cosidelu/vision-guided-helmet-inspection/documents/Presentazione_INNOVATIVE_APPLICATIONS_OF_INDUSTRIAL_ROBOTICS.pdf

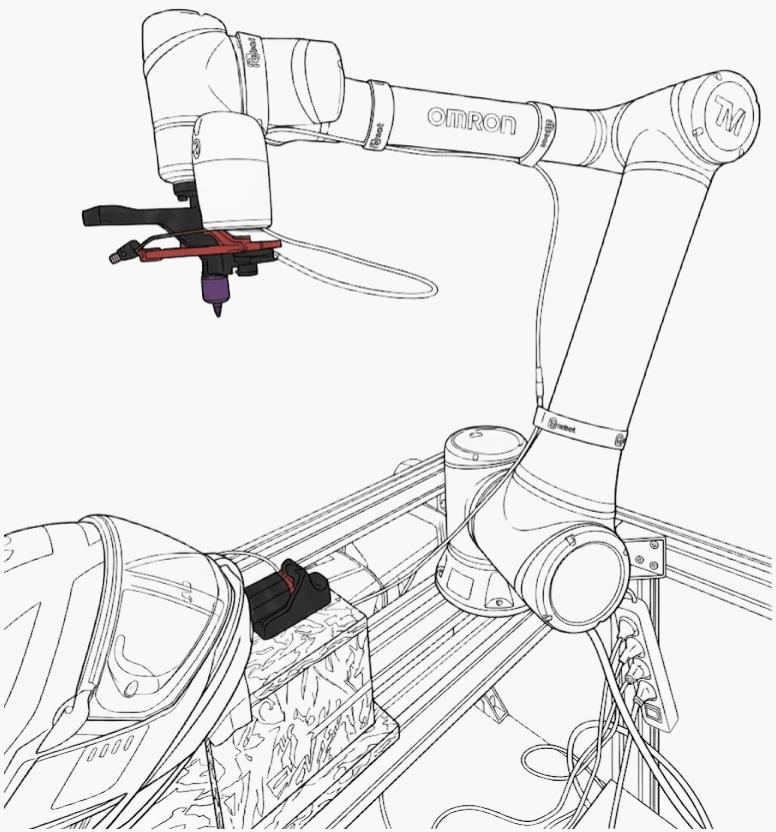
[picture p17: figure]

I NNO V AT I V E AP P L I C AT I O NS O F I NDUS T RI AL RO BO T I CS

# Robotic Cell for Automated Helmet Visor Testing and Visual Inspection

Authors

Cosimo De Luca · Matteo Casazza · Francesco Giglio · Marco Giavazzi

Alberto Feltrin · Donato Miraglia
Supervisor

Giovanni Bianchi

Academic Year

2025 / 2026

T HE G O AL

# PROJECT OBJECTIVES

Six pillars — each one anchors a section of this deck

CONSTRAINING

Constrain the helmet

rigidly & repeatably

END EFFECTOR

Integrated tool:

handling, vision &

marking

HANDLING

Robot control & Visor

tasks

ACQUISITION

Capture the surface

with the stereo-camera

DETECTION

Locate surface

defects automatically

INSPECTION
& MARKING
Identify, refine and mark

each detected defect

S E C T I O N 0 1 / 0 6

# Constraining

## Constrain the helmet rigidly and repeatably

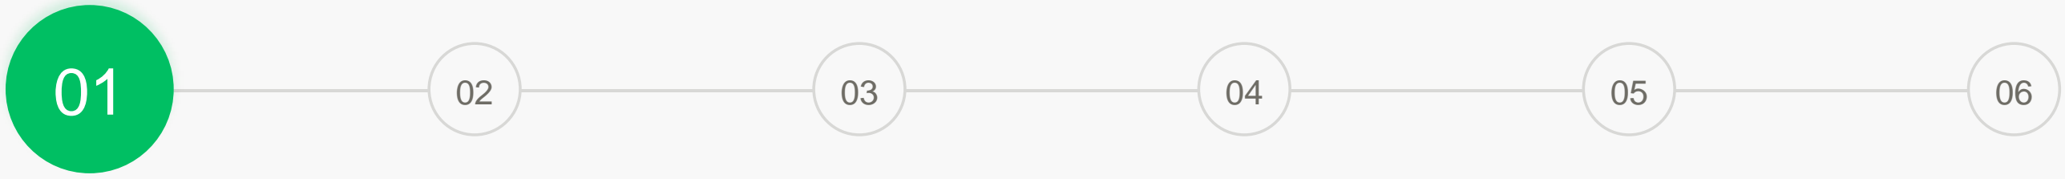
[picture p18: figure]

CONSTRAINING | END EFFECTOR | HANDLING | ACQUISITION | DETECTION | INSPECTION & MARKING

T HE O BJE CT

# ANATOMY OF THE HELMET

Key features the cell must handle

Constraining · Stage 1 / 6

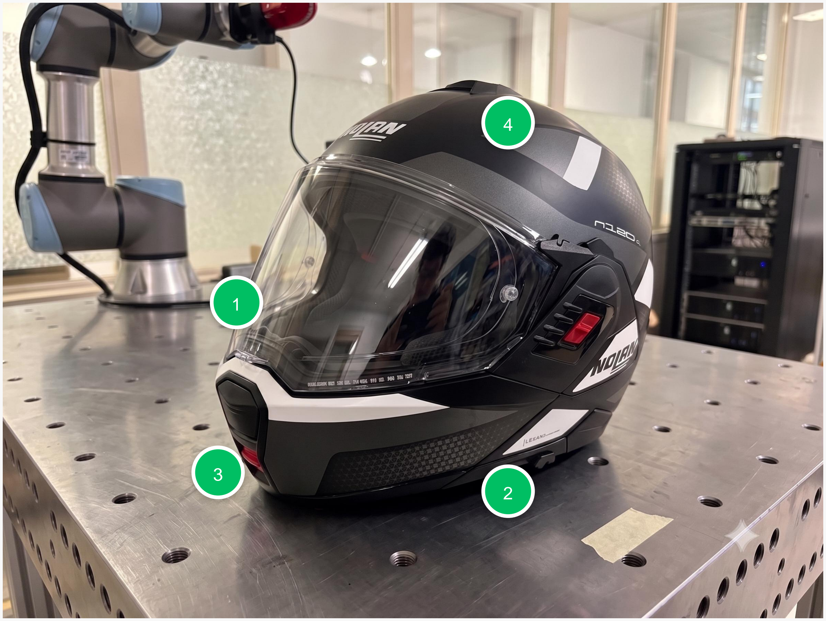
[picture p19: figure]

01 | Visor tab
| Tab that help for the opening of the visor
03 | Chin bar release button
| A mechanism to release the lower part of the
| helmet
02 | Sun-visor levers
| Slider that opens the inner sun visor and button
| to close it
04 | Inspection zone
| Zone of the helmet we have to inspect to find
| eventual damage

# DESIGNING THE FIXTURE

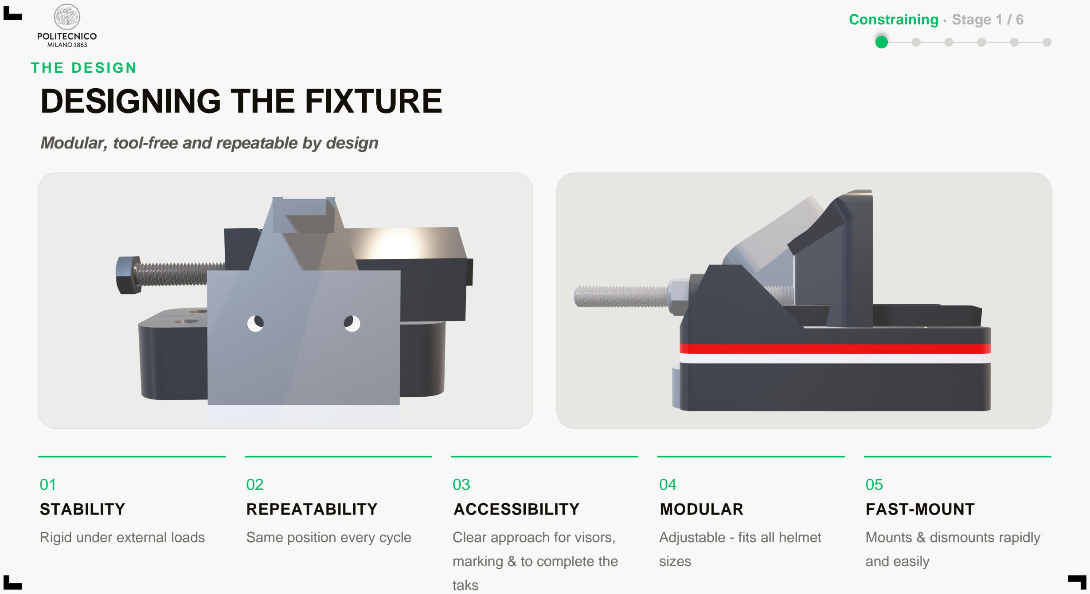
[picture p20: page 5]

T HE DE S I G N

Modular, tool-free and repeatable by design

Constraining · Stage 1 / 6

C

01
STABILITY

Rigid under external loads

02
REPEATABILITY

Same position every cycle

03
ACCESSIBILITY

Clear approach for visors,

marking & to complete the

taks

04
MODULAR

Adjustable - fits all helmet

sizes

05
FAST-MOUNT

Mounts & dismounts rapidly

and easily

# THE CLAMPING SYSTEM

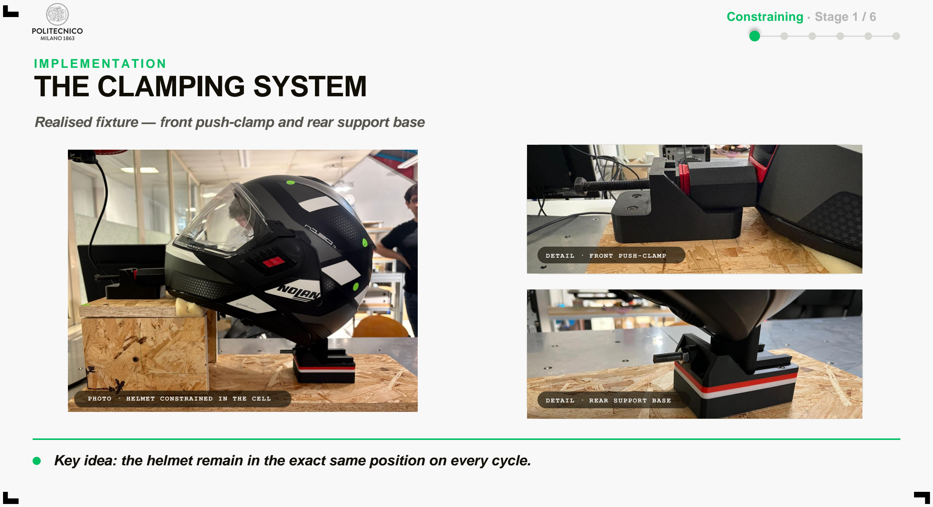
[picture p21: page 6]

I M P L E M E NT AT I O N

Realised fixture — front push-clamp and rear support base

Constraining · Stage 1 / 6

DET AIL · F RON T PU SH-CLA MP

DET AIL · R EAR S UP POR T B AS E

Key idea: the helmet remain in the exact same position on every cycle.

PHO TO · HE LME T CO NST RAI NE D IN TH E CEL L

# FORCES

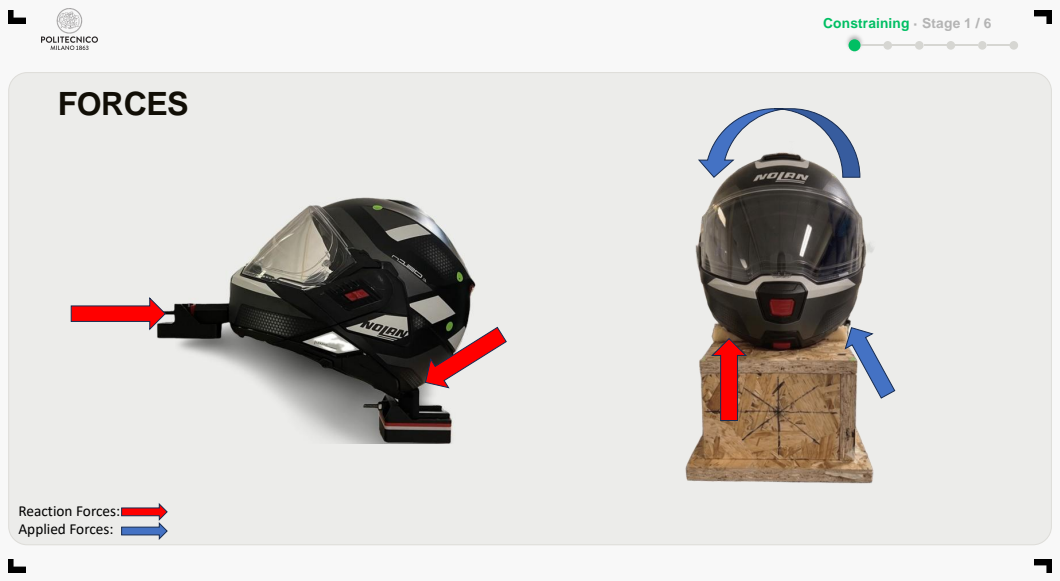
[picture p22: page 7]
Constraining · Stage 1 / 6; Reaction Forces: Applied Forces:

S E C T I O N 0 2 / 0 6

# End Effector

## One integrated tool for handling, vision and marking

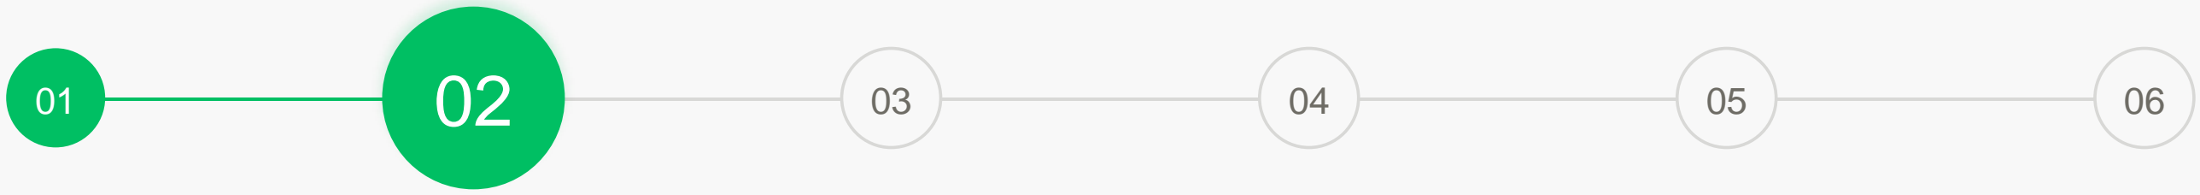
[picture p23: figure]

CONSTRAINING | END EFFECTOR | HANDLING | ACQUISITION | DETECTION | INSPECTION & MARKING

T HE DE S I G N

# END-EFFECTOR DESIGN

CAD model and bill of materials

End Effector · Stage 2 / 6

BILL OF MATERIALS

# | COMPONENT | QTY

01 | Base + Integrated Finger Rigid frame, robot mount & finger — One printed piece | 1
02 | Stereo-camera support
| Holds the ZED mini

1

03 | ZED mini stereo-camera
| 3D surface acquisition

1

04 | LED ring + support
| Illumination system

1

05 | Marker system
| Cap, Marker, Spring – Marking defects

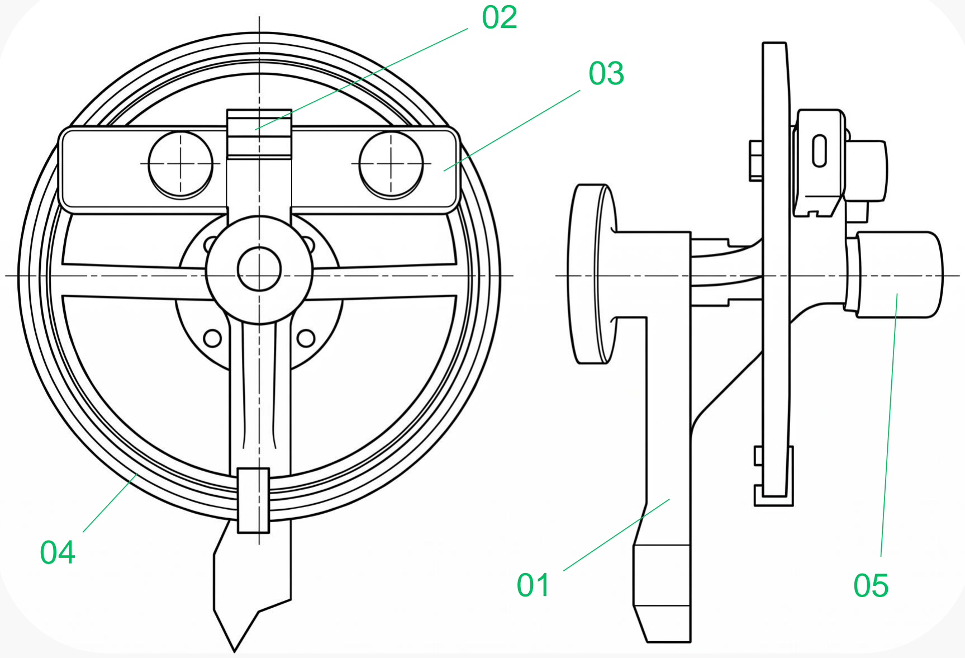
[picture p24: figure]

1 01

# ASSEMBLING THE END-EFFECTOR

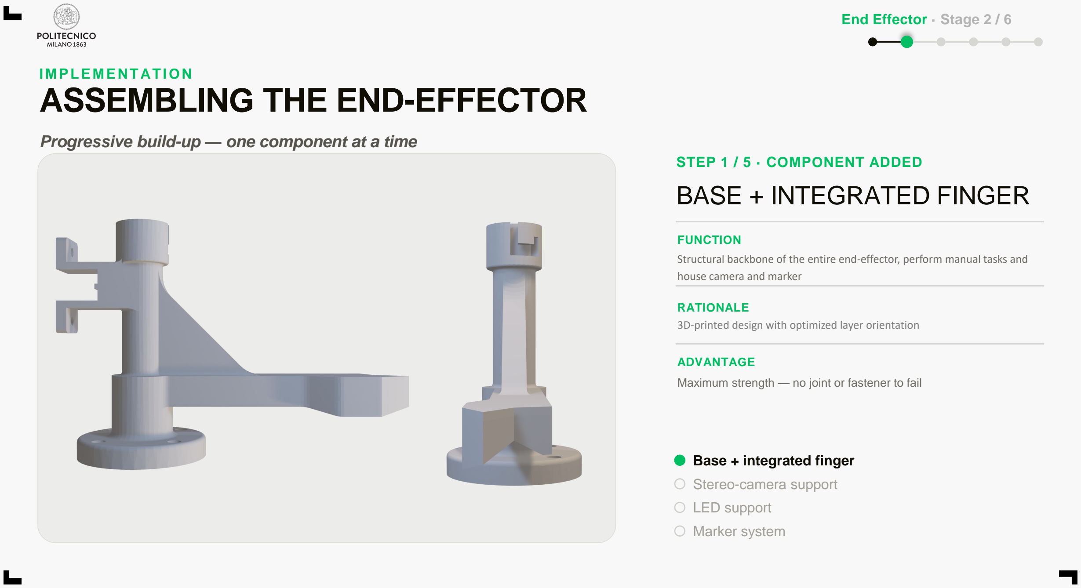
[picture p25: page 10]

I M P L E M E NT AT I O N

Progressive build-up — one component at a time

End Effector · Stage 2 / 6

STEP 1 / 5 · COMPONENT ADDED

# BASE + INTEGRATED FINGER

FUNCTION
Structural backbone of the entire end-effector, perform manual tasks and house camera and marker

RATIONALE
3D-printed design with optimized layer orientation

ADVANTAGE

Maximum strength — no joint or fastener to fail

Base + integrated finger

Stereo-camera support

LED support

Marker system

# ASSEMBLING THE END-EFFECTOR

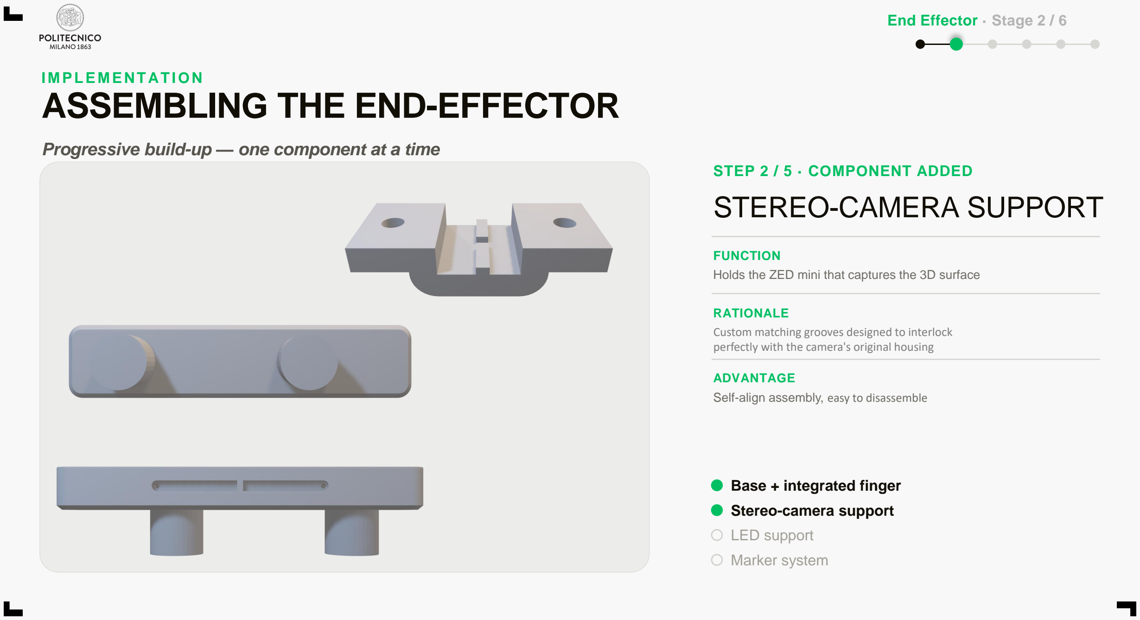
[picture p26: page 11]

I M P L E M E NT AT I O N

Progressive build-up — one component at a time

End Effector · Stage 2 / 6

STEP 2 / 5 · COMPONENT ADDED

# STEREO-CAMERA SUPPORT

FUNCTION
Holds the ZED mini that captures the 3D surface

RATIONALE
Custom matching grooves designed to interlock perfectly with the camera's original housing

ADVANTAGE
Self-align assembly, easy to disassemble

Base + integrated finger

Stereo-camera support

LED support

Marker system

# ASSEMBLING THE END-EFFECTOR

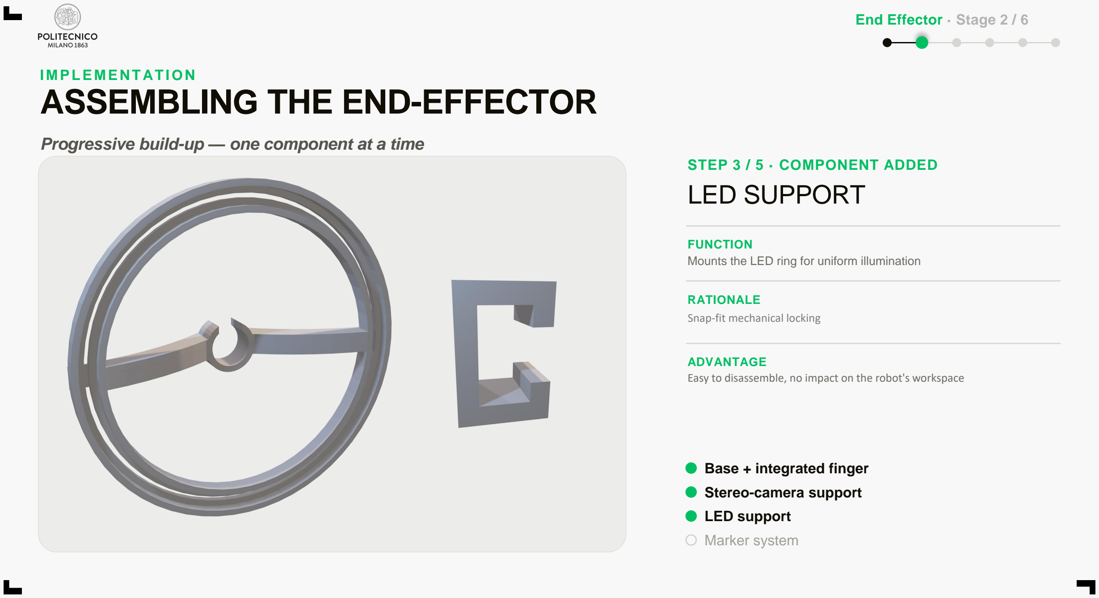
[picture p27: page 12]

I M P L E M E NT AT I O N

Progressive build-up — one component at a time

End Effector · Stage 2 / 6

STEP 3 / 5 · COMPONENT ADDED

# LED SUPPORT

FUNCTION
Mounts the LED ring for uniform illumination

RATIONALE
Snap-fit mechanical locking

ADVANTAGE
Easy to disassemble, no impact on the robot's workspace

Base + integrated finger

Stereo-camera support

LED support

Marker system

# ASSEMBLING THE END-EFFECTOR

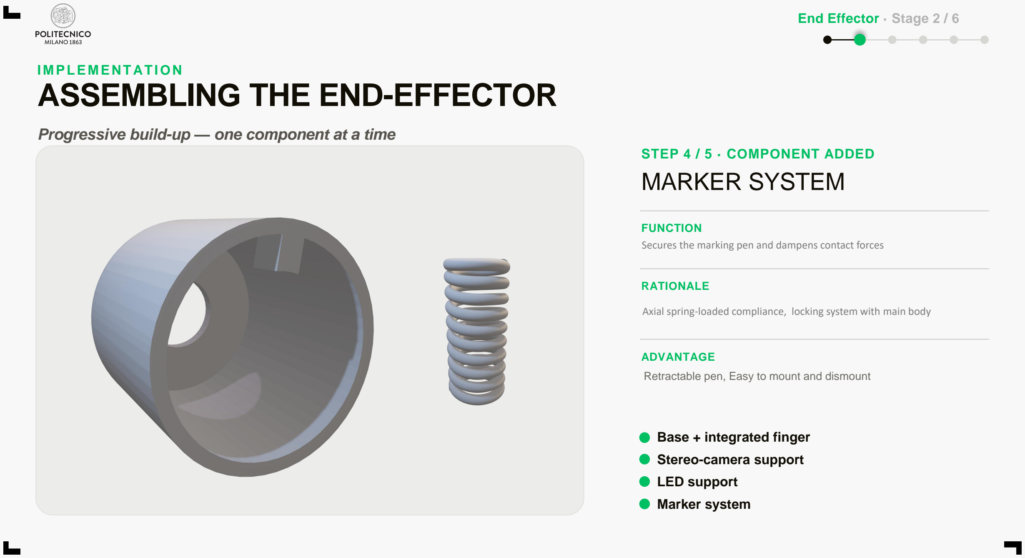
[picture p28: page 13]

I M P L E M E NT AT I O N

Progressive build-up — one component at a time

End Effector · Stage 2 / 6

STEP 4 / 5 · COMPONENT ADDED

# MARKER SYSTEM

FUNCTION
Secures the marking pen and dampens contact forces

RATIONALE

Axial spring-loaded compliance, locking system with main body

ADVANTAGE

Retractable pen, Easy to mount and dismount

Base + integrated finger

Stereo-camera support

LED support

Marker system

# ASSEMBLING THE END-EFFECTOR

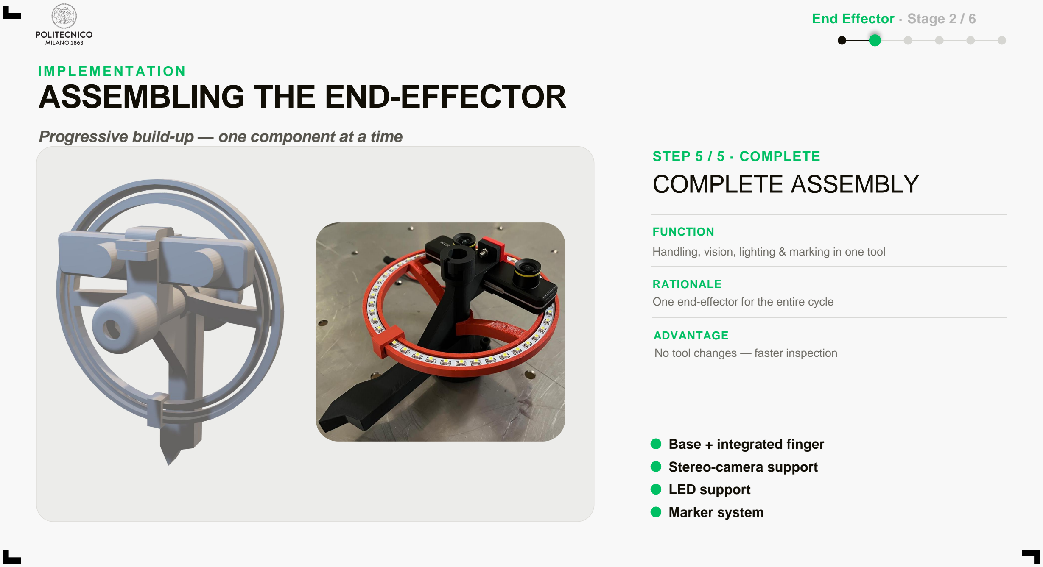
[picture p29: page 14]

I M P L E M E NT AT I O N

Progressive build-up — one component at a time

End Effector · Stage 2 / 6

STEP 5 / 5 · COMPLETE

# COMPLETE ASSEMBLY

FUNCTION

Handling, vision, lighting & marking in one tool

RATIONALE
One end-effector for the entire cycle

ADVANTAGE
No tool changes — faster inspection

Base + integrated finger

Stereo-camera support

LED support

Marker system

S E C T I O N 0 3 / 0 6

# Handling

## Robot control & Visor tasks

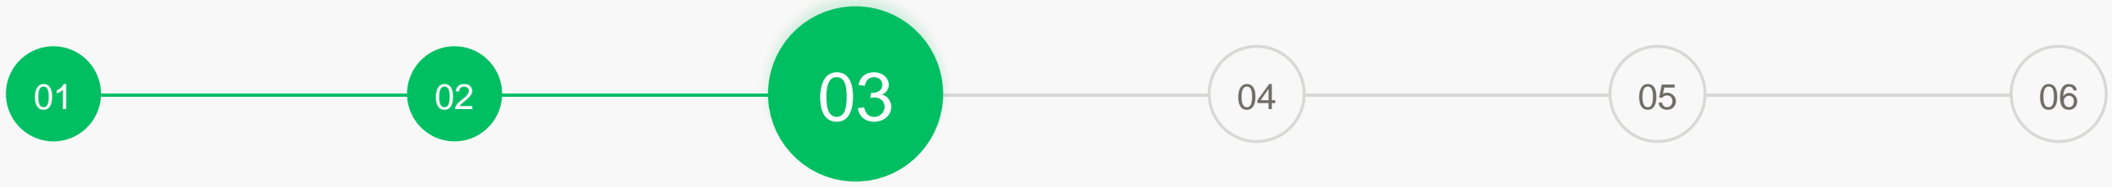
[picture p30: figure]

CONSTRAINING | END EFFECTOR | HANDLING | ACQUISITION | DETECTION | INSPECTION & MARKING

HANDL I NG

# SOFTWARE ARCHITECTURE

Modular architecture, orchestrated by two workflows

Handling · Stage 3 / 6

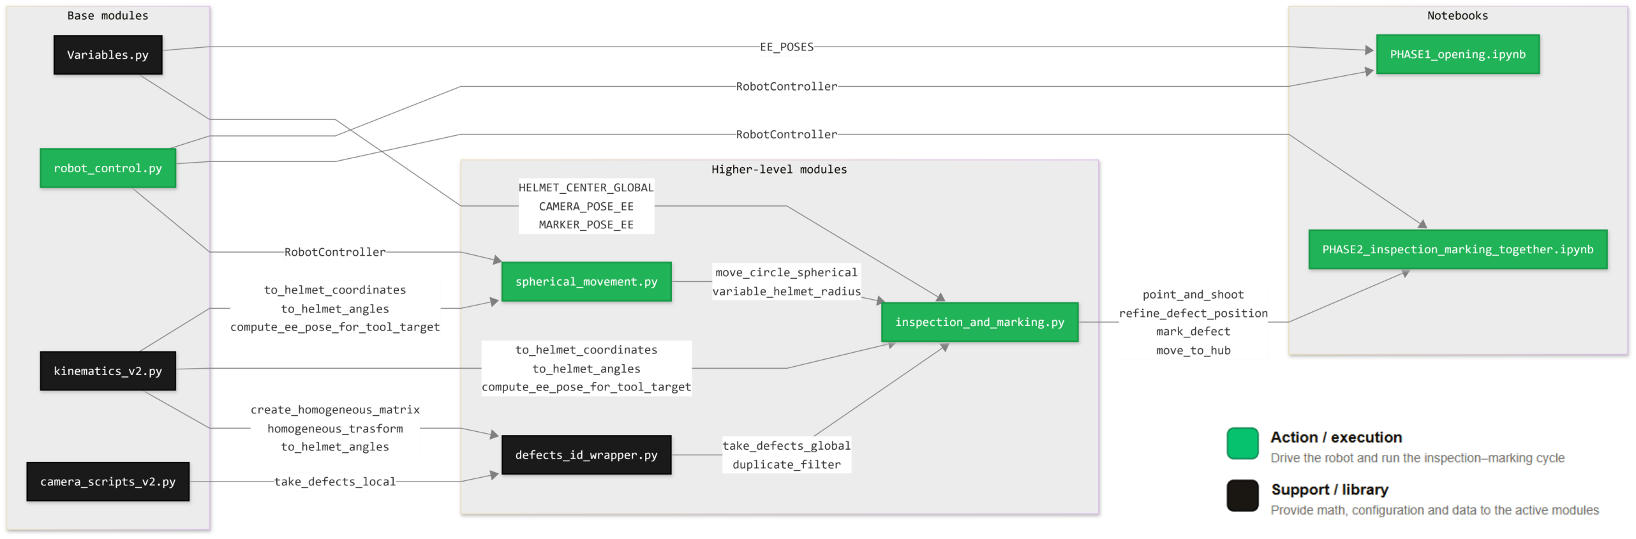
[picture p31: figure]

HANDL I NG

# ROBOT CONTROL

Listen Node commands, Modbus TCP feedback

Handling · Stage 3 / 6

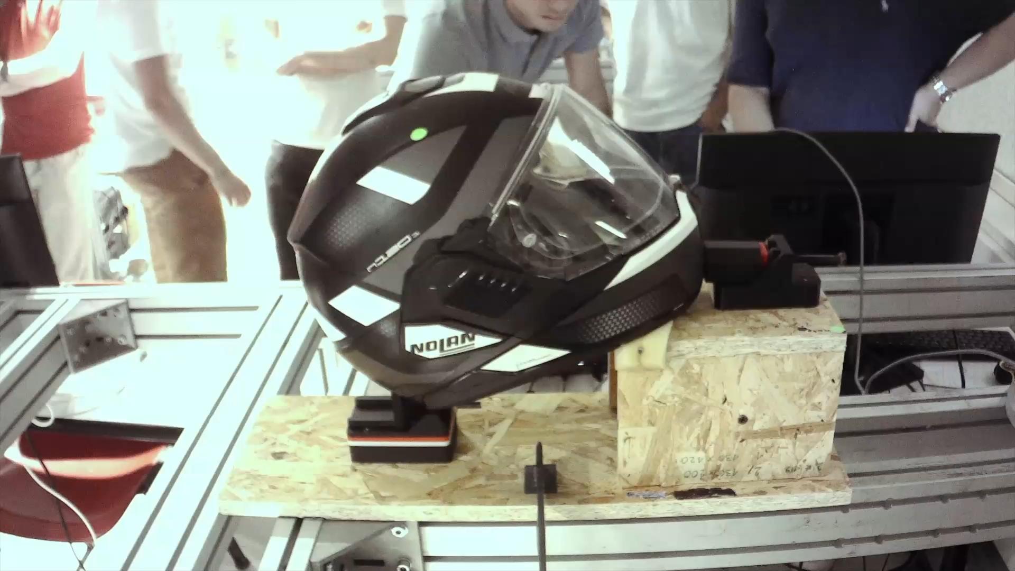
[picture p32: figure]

01 COMMAND INTERFACE
A single class sends motion scripts to the Techman

Listen Node and reads the pose back over Modbus

TCP.

02 SYNCHRONOUS & BLOCKING

The program waits until the robot reaches the target

within a tolerance, by continuously polling the pose

03 MOTION PRIMITIVES
Joint moves, Cartesian point-to-point, linear moves

on the TCP, and 3D arcs
04 SAFETY

Home pose, emergency stop and a movement

timeout

HANDL I NG

# REFERENCE FRAMES & THE MATRIX H

One 4×4 carries rotation and translation

Handling · Stage 3 / 6

01 | FOUR REFERENCE FRAMES Robot base - End-Effector (TCP) - tool (camera and marker, each with its own fixed offset) - helmet
02 | ONE MATRIX H (4×4) Rotation R (3×3) + translation T (3×1) in a single block takes a point

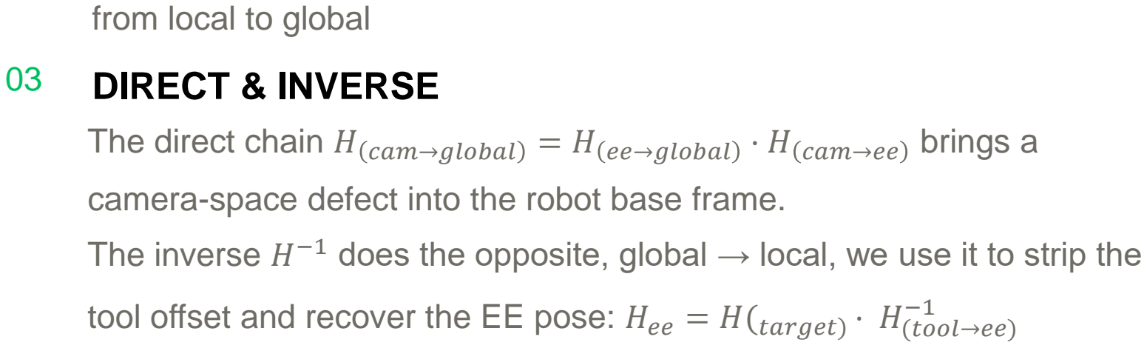
[picture p33: figure]
from local to global; DIRECT & INVERSE; · H cam→ee brings a; The inverse H; · H(tool→ee)

The direct chain H cam→global = H ee→global

camera-space defect into the robot base frame.
−1 does the opposite, global → local, we use it to strip the

tool offset and recover the EE pose: Hee = H(target)

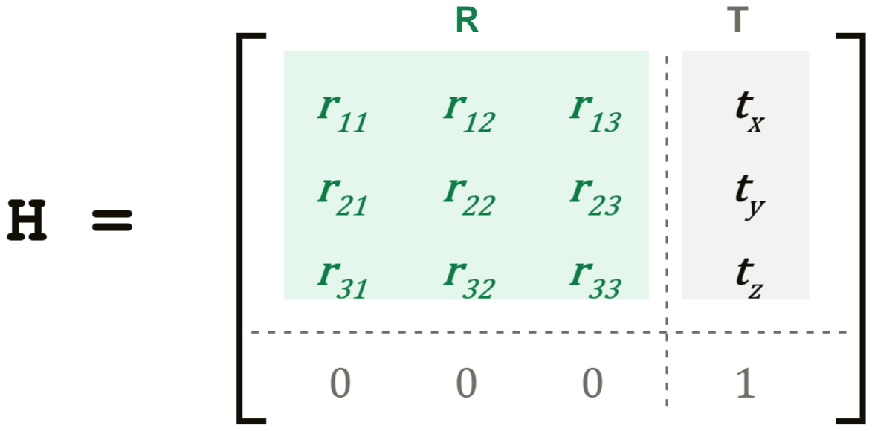
[picture p34: figure]

### P global = H · P local

# ROTATION MATRIX ANGLES

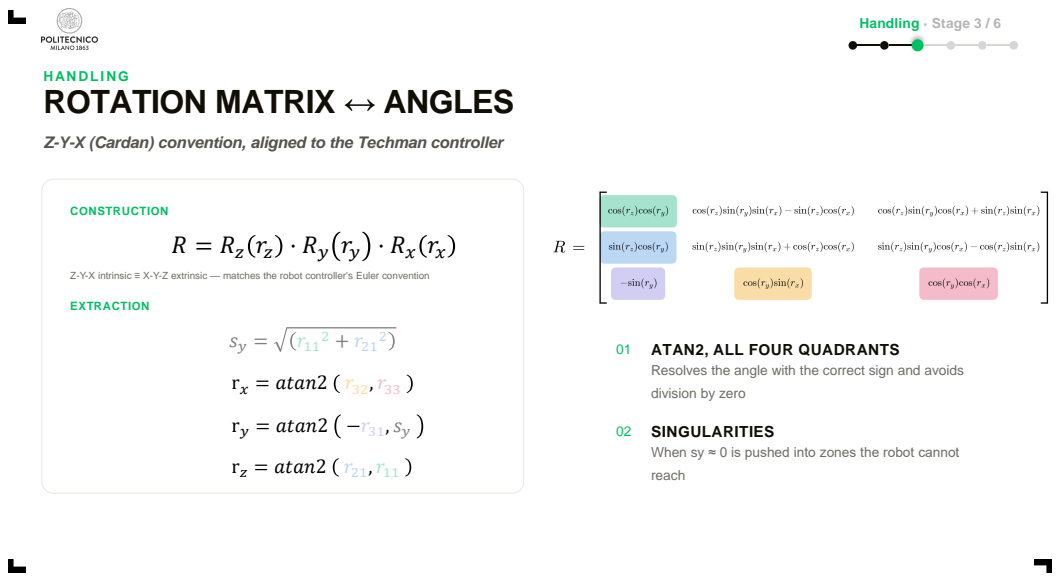
[picture p35: page 19]
HANDL I NG; Handling · Stage 3 / 6; CONSTRUCTION; EXTRACTION; ATAN2, ALL FOUR QUADRANTS; SINGULARITIES; rx = atan2 r32, r33; ry = atan2 −r31, sy; rz = atan2 r21, r11

Z-Y-X (Cardan) convention, aligned to the Techman controller

Z-Y-X intrinsic ≡ X-Y-Z extrinsic — matches the robot controller's Euler convention

Resolves the angle with the correct sign and avoids
division by zero

When sy ≈ 0 is pushed into zones the robot cannot
reach

# FROM OUR ROBOT TO ANY ROBOT

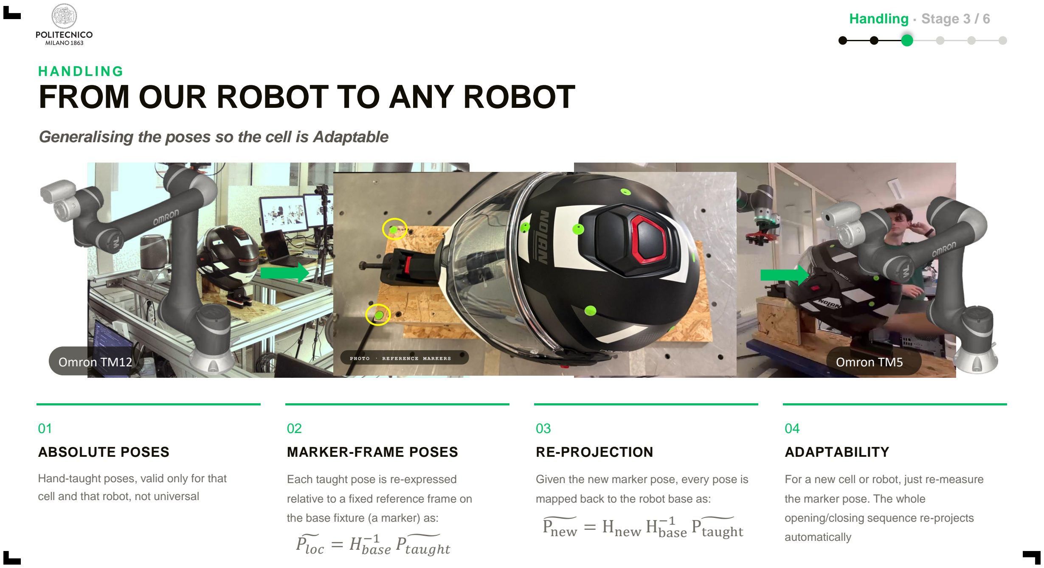
[picture p36: page 20]

HANDL I NG

Generalising the poses so the cell is Adaptable

Handling · Stage 3 / 6

01

ABSOLUTE POSES

Hand-taught poses, valid only for that cell and that robot, not universal

02

MARKER-FRAME POSES

Each taught pose is re-expressed

relative to a fixed reference frame on

the base fixture (a marker) as:

03

RE-PROJECTION

Given the new marker pose, every pose is

mapped back to the robot base as:

04

ADAPTABILITY

For a new cell or robot, just re-measure

the marker pose. The whole

opening/closing sequence re-projects ෫ | automatically
Pnew = Hnew Hbase

−1 P෫taught
P෪loc = Hbase

−1 Ptaugℎt ෫

P H O T O · R E F E R E N C E M A R K E R S Omron TM12 | Omron TM5

S E C T I O N 0 4 / 0 6

# Acquisition

## Capture the surface with the stereo-camera

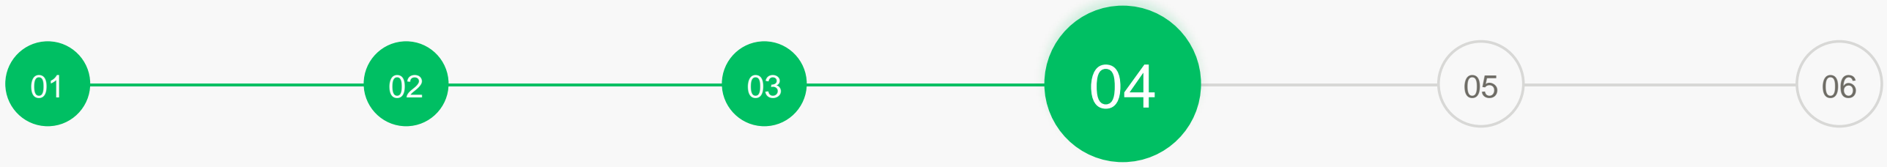
[picture p37: figure]

CONSTRAINING | END EFFECTOR | HANDLING | ACQUISITION | DETECTION | INSPECTION & MARKING

ACQ UI S I T I O N

# AUTOMATED HELMET INSPECTION SYSTEM

3D Computer Vision & Robotic Kinematics for Defect Control

Acquisition · Stage 4 / 6

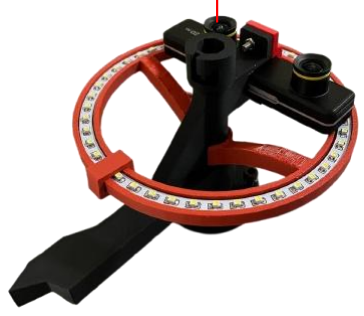
[picture p38: figure]

01 | HELMET CENTER
| The core coordinate
02 | STEREO-CAMERA
| Hardware configuration: Eye-in-Hand-system (camera rigidly attached to the EE)
03 | 3D SURFACE SCANNING
| Continuos, automated 3D surface scanning ensuring perpendicularity

Z෡cam

# ORIENTATION CONSTRAINT: LOCAL Z-AXIS TRACKING

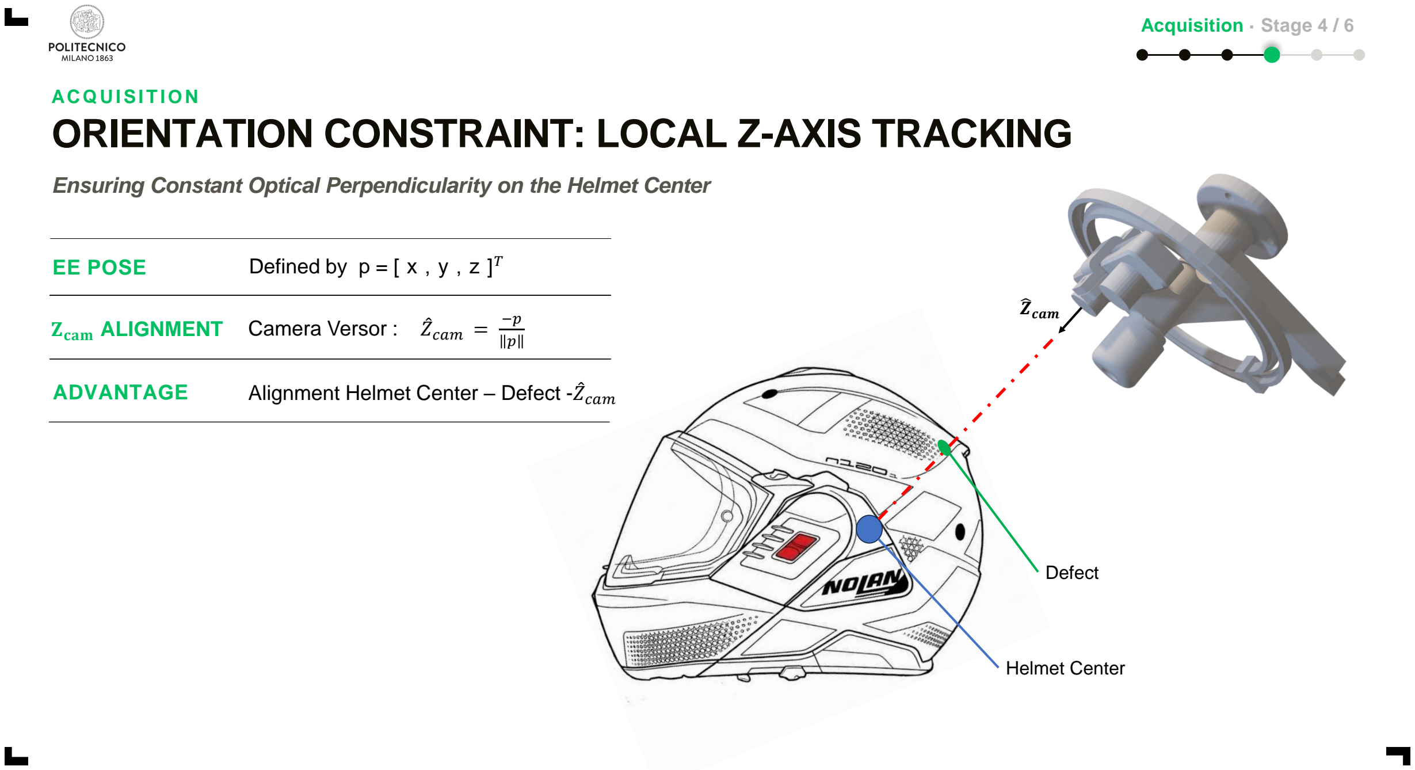
[picture p39: page 23]

ACQ UI S I T I O N

Acquisition · Stage 4 / 6

Ensuring Constant Optical Perpendicularity on the Helmet Center

Helmet Center

Defect

EE POSE | Defined by p = [ x , y , z ] T
Zcam ALIGNMENT | Camera Versor : Zመ cam = −p p
ADVANTAGE | Alignment Helmet Center – Defect -Zመ
cam

Z෡cam

# TRAJECTORY GENERATION: VARIABLE HELMET RADIUS (VHR)

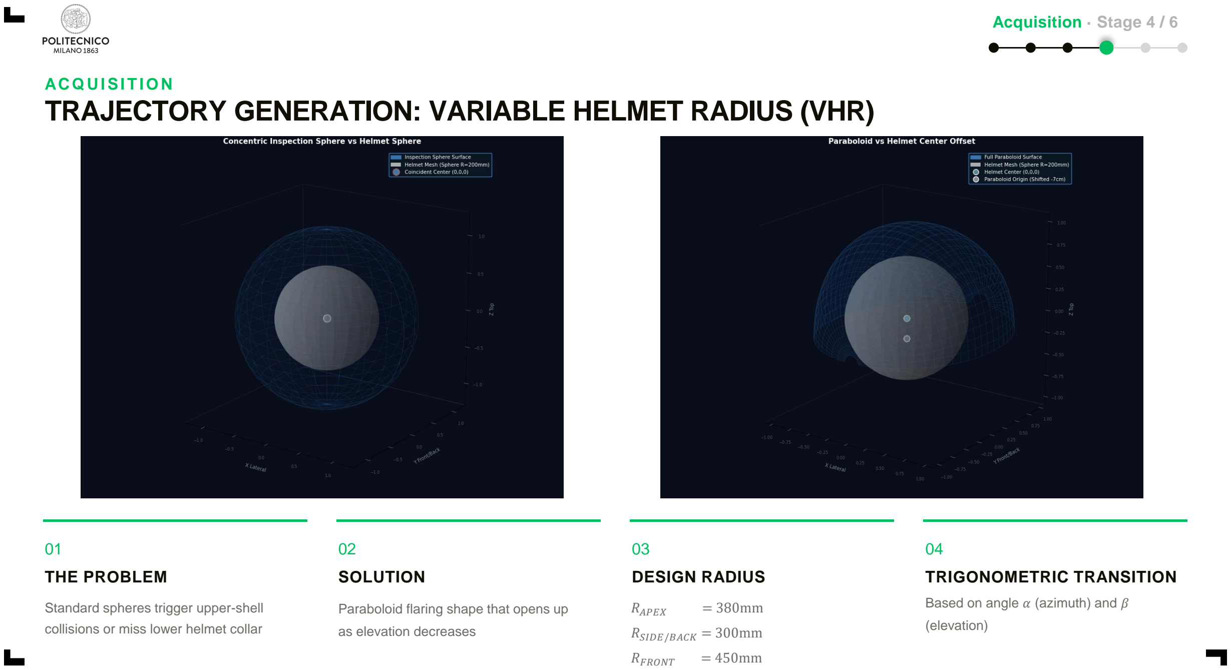
[picture p40: page 24]

ACQ UI S I T I O N

Acquisition · Stage 4 / 6

01

THE PROBLEM

Standard spheres trigger upper-shell collisions or miss lower helmet collar

02

SOLUTION

Paraboloid flaring shape that opens up

as elevation decreases

03

DESIGN RADIUS

RAPEX = 380mm

RSIDE/BACK = 300mm

RFRONT = 450mm

04

TRIGONOMETRIC TRANSITION

Based on angle α (azimuth) and β

(elevation)

ACQ UI S I T I O N

# COLLISION AVOIDANCE & VIRTUAL ENVIROMENT VALIDATION

Acquisition · Stage 4 / 6

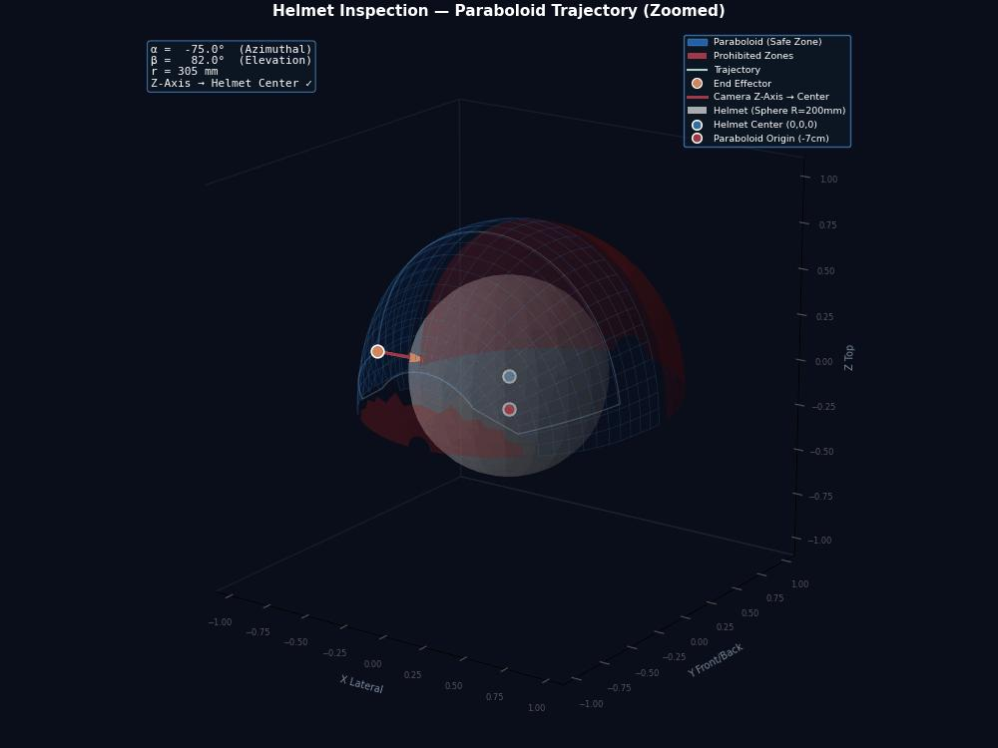
[picture p41: figure]

Bridging Algirithmic Safety with Digital Twin Validation

UNSAFE ZONES

01 | Gimbal Lock Prevention | α | > 89°
02 | Low Boundary Collision | β < 20 + 25

α
90

2

03 | Out-of-Bounds Limit | β > 110°

DIGITAL TWIN PARAMETERS

01 | Helmet modeled as a sphere | R = 200mm
02 | Paraboloid centre | 0, 0, −70
03 | Scaling Normalization | ൗ
| | 1 RAPEX

ACQ UI S I T I O N

# IMAGE ACQUISITION

Stereo-camera capture images during the scan

Acquisition · Stage 4 / 6

01

RGB IMAGES

Used for colour masks and 2D defect extraction

02

XYZ POINT CLOUD

Used to estimate the defect position in camera

frame

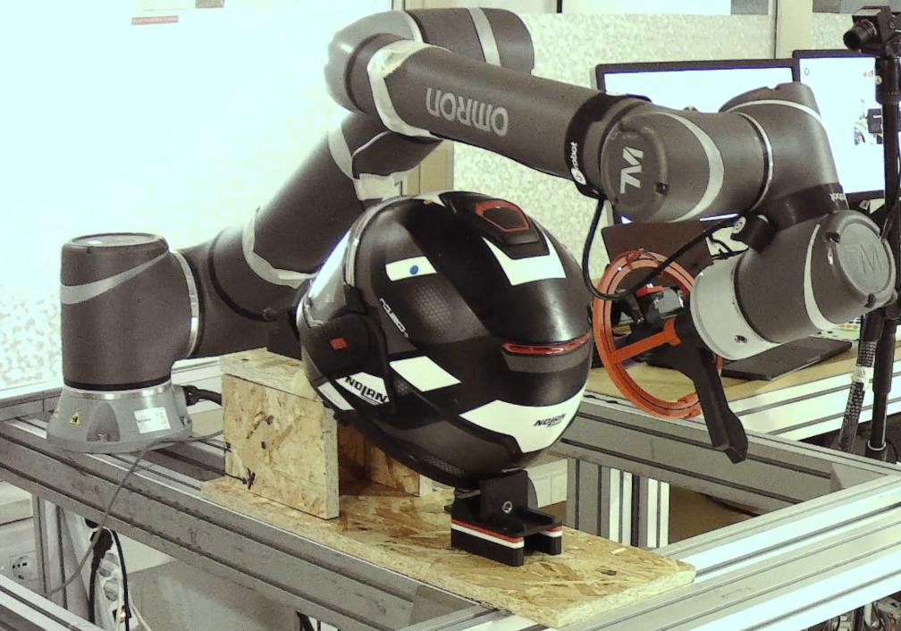
[picture p42: figure]

RGB gives the 2D evidence; XYZ gives the depth information.

S E C T I O N 0 5 / 0 6

# Detection

## Locate the surface defects automatically

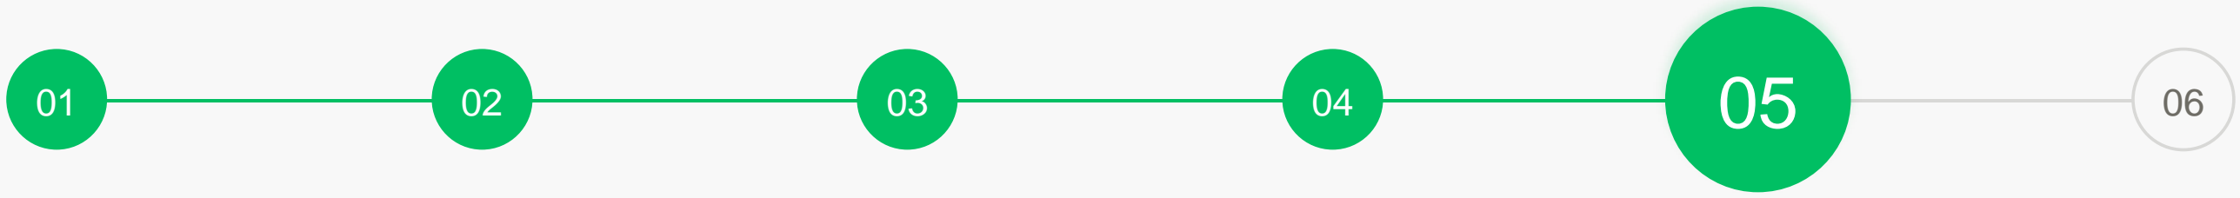
[picture p43: figure]

CONSTRAINING | END EFFECTOR | HANDLING | ACQUISITION | DETECTION | INSPECTION & MARKING

DE T E CT I O N

# 2D DEFECT DETECTION: FROM MASK TO CENTROID

HSV segmentation is cleaned and converted into isolated defect candidates

Direct green mask

Green known colour
BGR → HSV → green threshold

Inverse anomaly mask

For generic unknown colour
BGR →HSV → helmet colours threshold → inversion of the mask

01

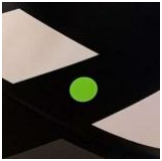
[picture p44: figure]
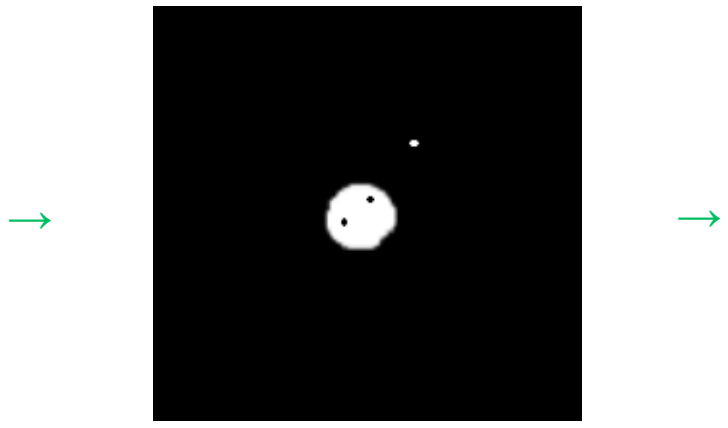
[picture p45: figure]
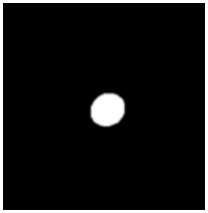
[picture p46: figure]

MASK CLEANING

Attention radius →useful field of view

Opening → removes isolated noises

Closing → fills small holes

02

MASK GENERATION

Detection · Stage 5 / 6

DE T E CT I O N

# 2D DEFECT DETECTION: FROM MASK TO CENTROID

HSV segmentation is cleaned and converted into isolated defect candidates

BLOB FILTERING

Find external contourns

Reject small blobs by area threshold

03 | CENTROID & ISOLATED MASK
| Compute area and centroid from image
| Store one isolated mask for defect

04

Detection · Stage 5 / 6

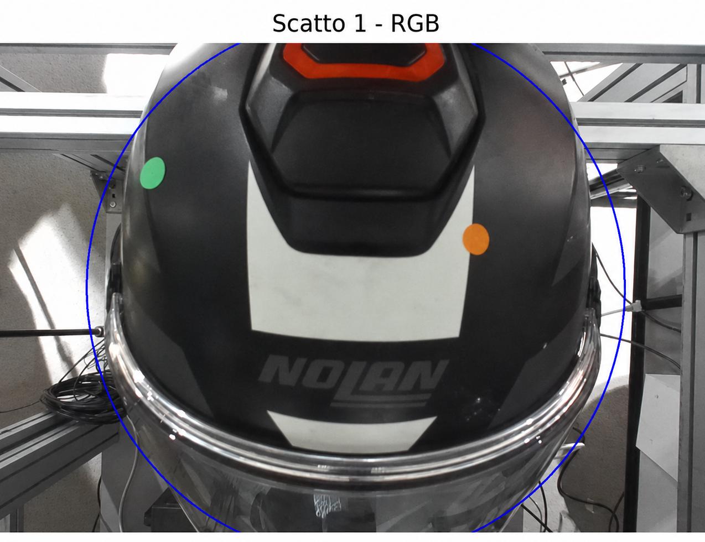
[picture p47: figure]
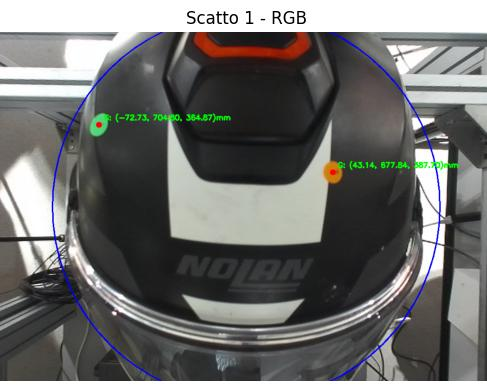
[picture p48: figure]
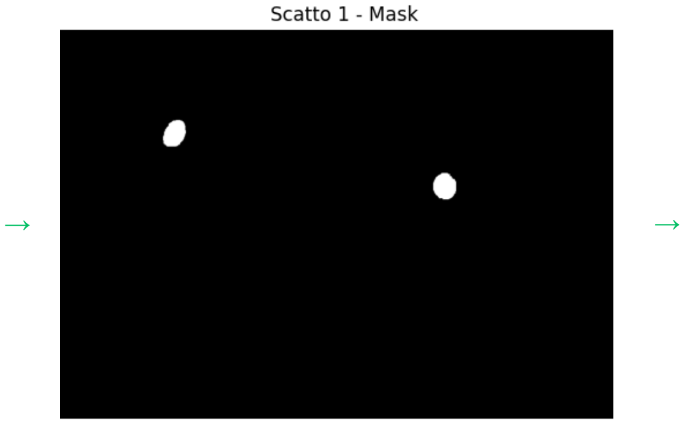
[picture p49: figure]

# FROM 2D MASK TO 3D DEFECT POSITION

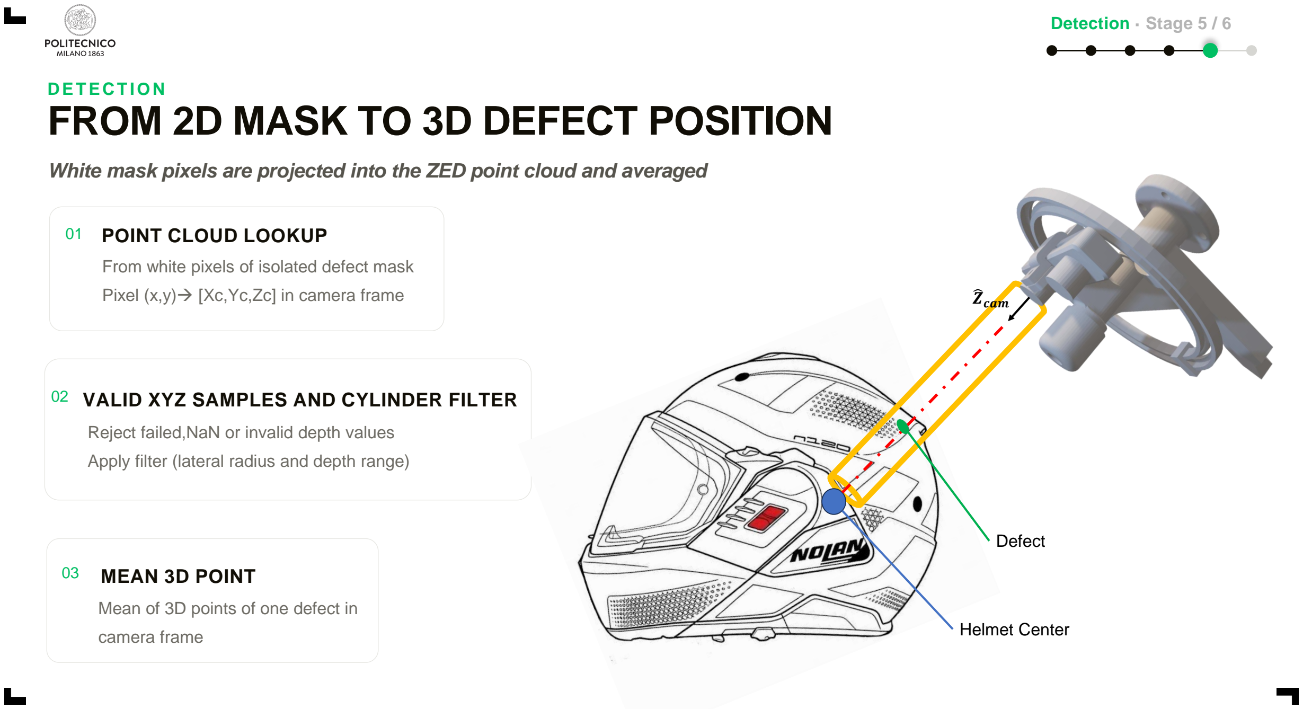
[picture p50: page 30]

DE T E CT I O N

White mask pixels are projected into the ZED point cloud and averaged

From white pixels of isolated defect mask Pixel (x,y)→ [Xc,Yc,Zc] in camera frame

01

VALID XYZ SAMPLES AND CYLINDER FILTER

Reject failed,NaN or invalid depth values

Apply filter (lateral radius and depth range)

02

MEAN 3D POINT

Mean of 3D points of one defect in

camera frame

03

POINT CLOUD LOOKUP

Helmet Center

Defect

Z෡cam

Detection · Stage 5 / 6

# FROM CAMERA FRAME TO HELMET TARGET

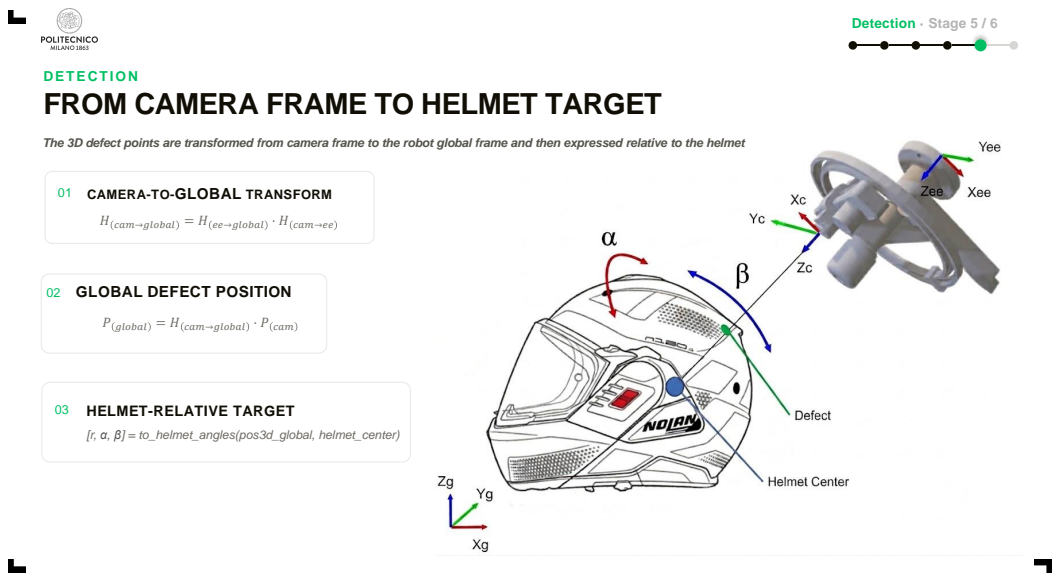
[picture p51: page 31]
[r, α, β] = to_helmet_angles(pos3d_global, helmet_center); Detection · Stage 5 / 6

The 3D defect points are transformed from camera frame to the robot global frame and then expressed relative to the helmet

CAMERA-TO-GLOBAL TRANSFORM

H cam→global = H ee→global · H cam→ee

GLOBAL DEFECT POSITION

P global = H cam→global · P cam

HELMET-RELATIVE TARGET

DE T E CT I O N

# COMPLETE VISION PIPELINE

Detection · Stage 5 / 6

RGB image and point cloud are converted into helmet-relative defect coordinates

01
Inspection pose

Camera normal to shell

→

02

RGB + point cloud

Zed acquisition

→

03

Colour mask

Green or inverse colours

→

04

2D Filtering

Morphology + Area

→

05

3D camera point

Mask pixels → XYZ mean

→

06

Global transform

Camera frame →

robot frame

→

07

Spherical transform

Robot frame → Helmet

frame

→

→

→

08
ALL DEFECT LIST

2D Evidence

Centroid = [cx, cy]
Area
Isolated binary mask
RGB debug image

3D Localization
Points3d
Pos3d_camera = [Xc, Yc, Zc] Pos3d_global = [Xg, Yg, Zg] Sph_coord = [r, α, β]

S E C T I O N 0 6 / 0 6

# Inspection & Marking

## Identifying, refining and marking each detected defect on the shell

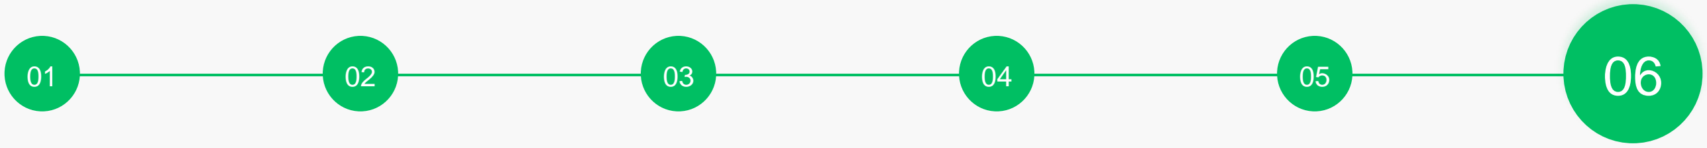
[picture p52: figure]

CONSTRAINING | END EFFECTOR | HANDLING | ACQUISITION | DETECTION | INSPECTION & MARKING

I NS P E CT I O N & M ARKI NG

# TOOL POSITIONING

Controlling the tool position via the robot pose

Inspection & Marking · Stage 6 / 6

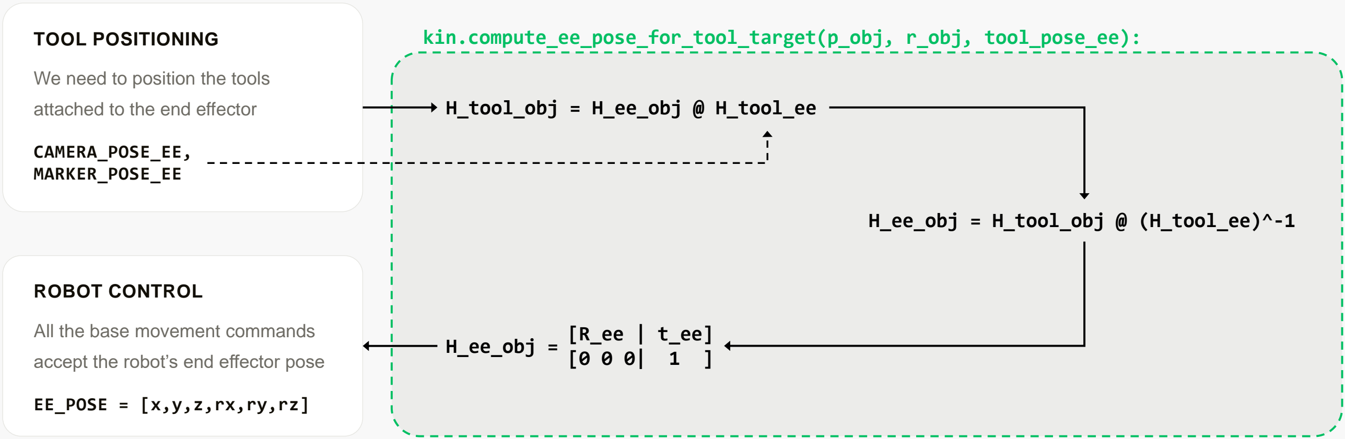
[picture p53: figure]
ROBOT CONTROL; All the base movement commands; accept the robot’s end effector pose; EE_POSE = [x,y,z,rx,ry,rz]; TOOL POSITIONING; We need to position the tools; attached to the end effector; CAMERA_POSE_EE, MARKER_POSE_EE; H_ee_obj = H_tool_obj @ (H_tool_ee)^-1; H_tool_obj = H_ee_obj @ H_tool_ee; kin.compute_ee_pose_for_tool_target(p_obj, r_obj, tool_pose_ee):; H_ee_obj =

I NS P E CT I O N & M ARKI NG

# HELMET INSPECTION

Initial inspection of the helmet to find all defects

Inspection & Marking · Stage 6 / 6

INSPECTION POSITIONS

We manually set multiple inspection

positions that will cover all of the

helmet’s inspectionable surface

INSPECTION_POSITIONS = [
[r, 0, 90], | # top
[r, 0, 45], | # front1
[r, 0, 25], | # front2
[r, 45, 45], # lat dx1
[r, 40, 80], # lat dx2
[r, -40, 80], # lat sx2
[r, -45, 45], # lat sx1
]

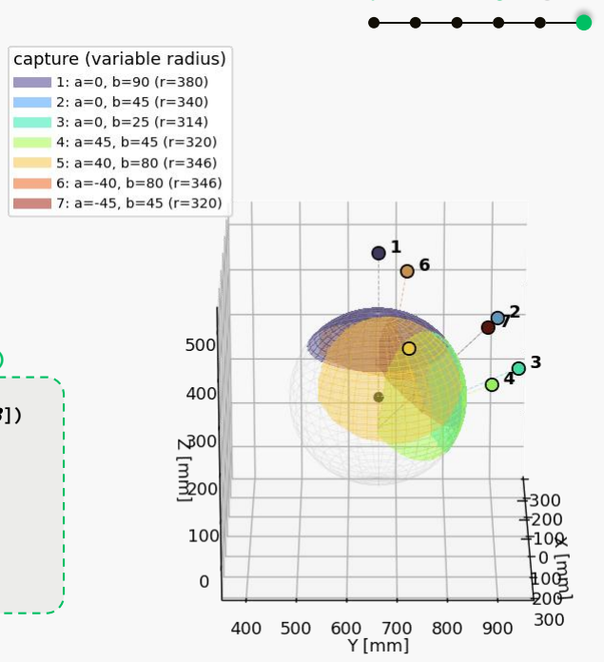
[picture p54: figure]

move_circle_spherical([r,α,β])

#image stabilization

time.sleep(1)

take_defects_global()

defect_list.append()

im.point_and_shoot([r,α,β])

I NS P E CT I O N & M ARKI NG

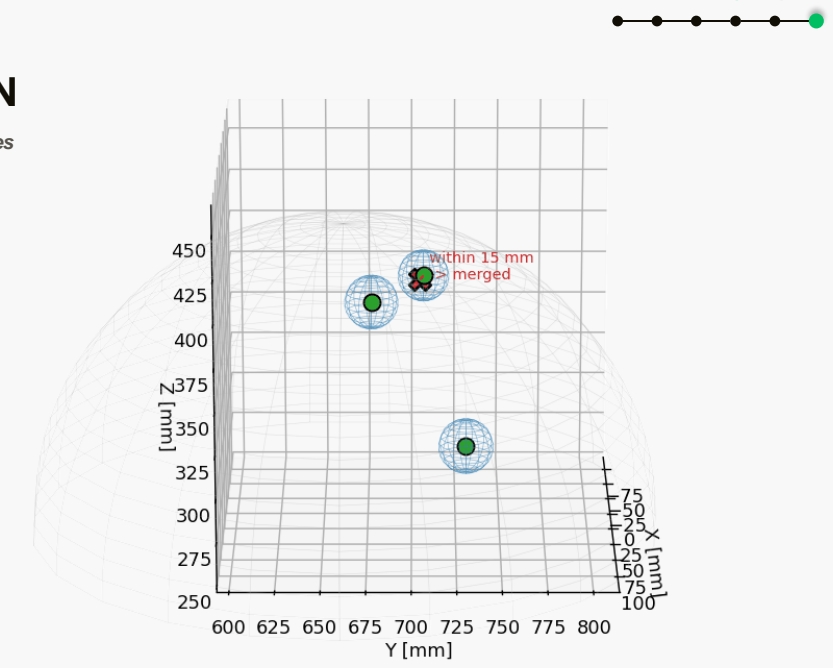
[picture p55: figure]

# HELMET INSPECTION

Filtering of defects identified multiple times

Inspection & Marking · Stage 6 / 6

DUPLICATE FILTERING

By computing the distance between

all defects, we can indetify the ones

that are too close (under a certain

threshold) and keep only the one

with the largest area.

for d in defect_list:

if dist < threshold:
keep largest area

unique.append(d)

im.duplicate_filter(defects)

# DEFECT REFINEMENT AND MARKING

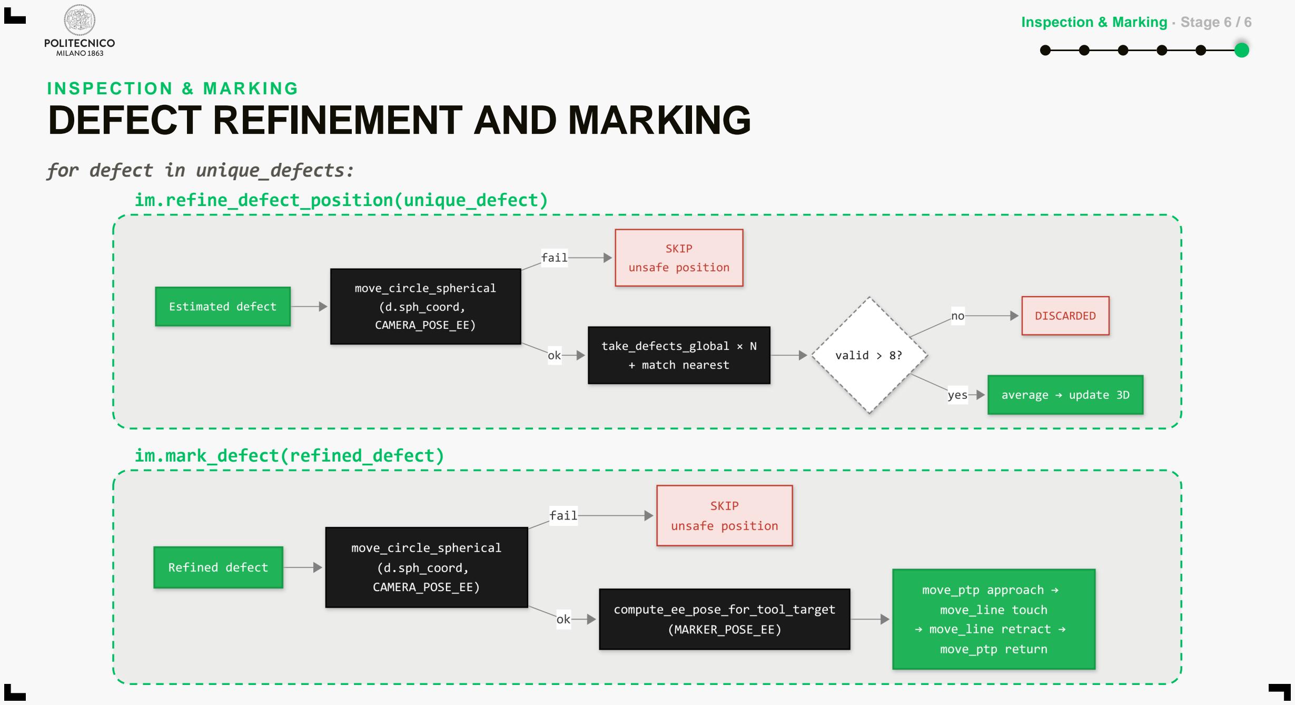
[picture p56: page 37]

I NS P E CT I O N & M ARKI NG

### for defect in unique_defects:

Inspection & Marking · Stage 6 / 6

im.refine_defect_position(unique_defect)

im.mark_defect(refined_defect)

# DEFECT REFINEMENT AND MARKING

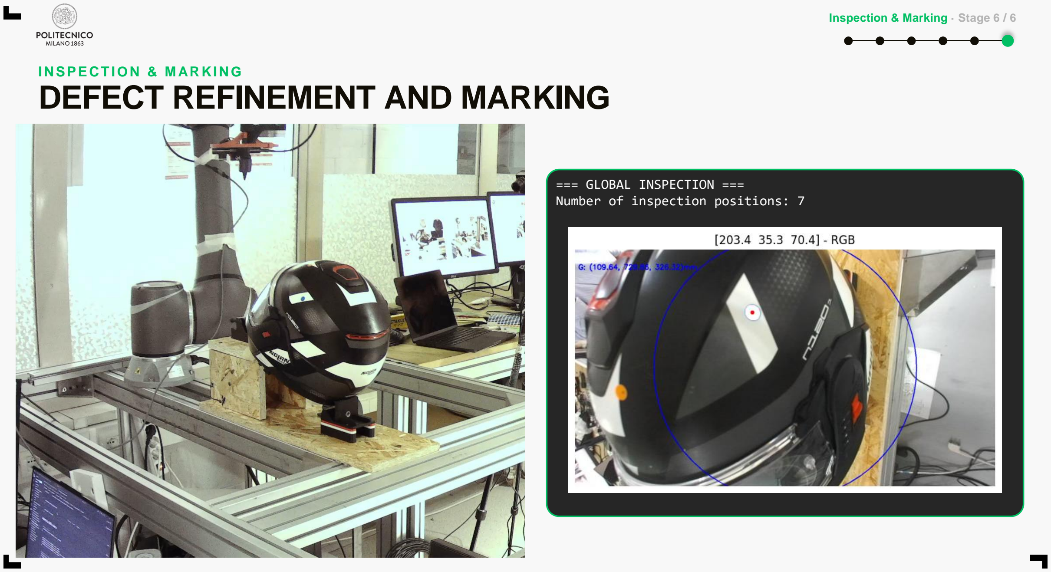
[picture p57: page 38]

=== GLOBAL INSPECTION ===
Number of inspection positions: 7

I NS P E CT I O N & M ARKI NG

Inspection & Marking · Stage 6 / 6

# CONCLUSIONS

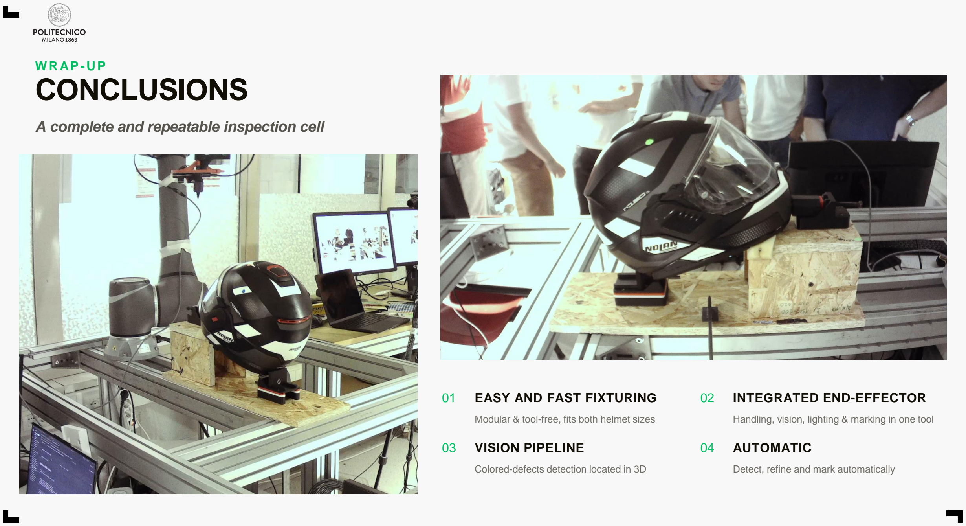
[picture p58: page 39]

W RAP-UP

01 EASY AND FAST FIXTURING

Modular & tool-free, fits both helmet sizes

02 INTEGRATED END-EFFECTOR

Handling, vision, lighting & marking in one tool

03 VISION PIPELINE

Colored-defects detection located in 3D

04 AUTOMATIC

Detect, refine and mark automatically

A complete and repeatable inspection cell
