cosidelu/vision-guided-helmet-inspection/media/thumbnail.png

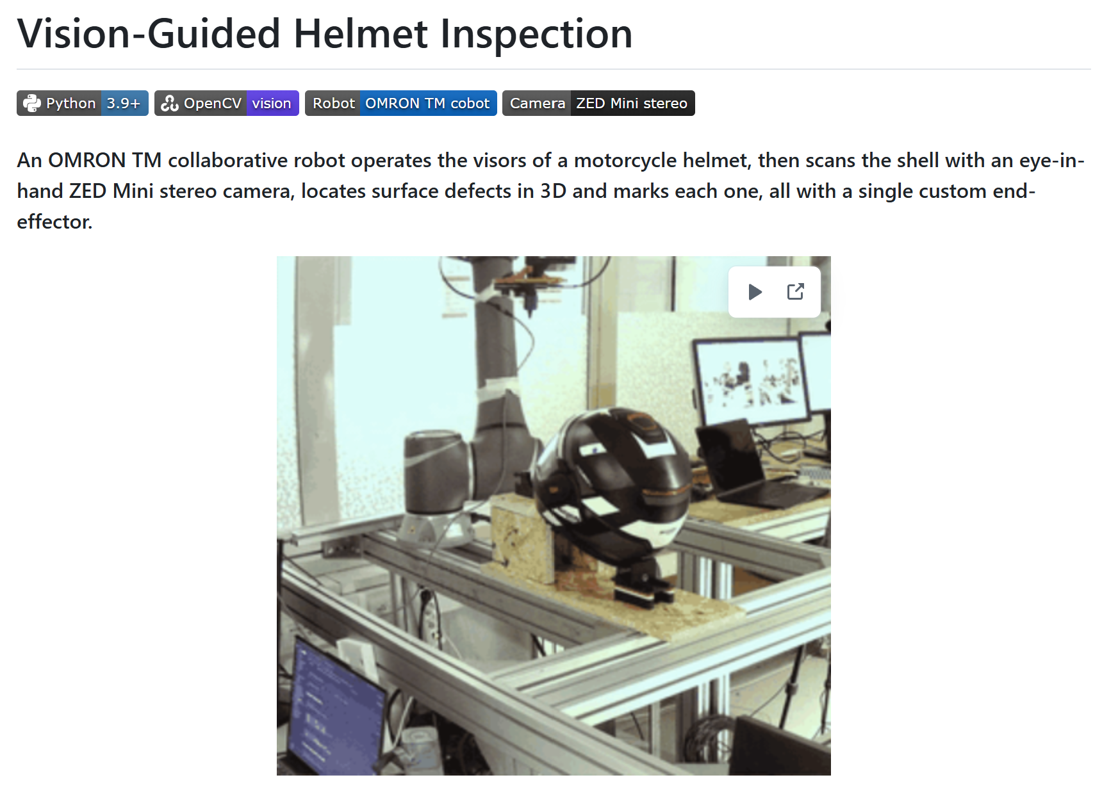
media/thumbnail.png
