cosidelu/vision-guided-helmet-inspection/cad/End-Effector/End-Effector Assembly.SLDASM

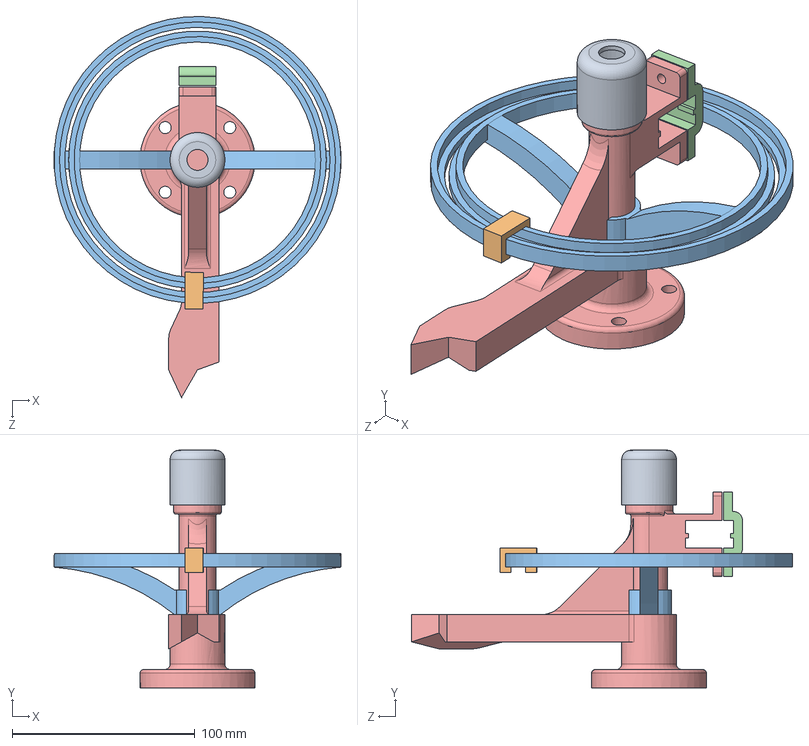
[picture p60: CAD file, 2026-09-28]
cad/End-Effector/End-Effector Assembly.SLDASM
157.0 x 130.0 x 208.5 mm
end_effector_3
coperchio con scanalatura
supporto_luce_tasche_3 x 2
gancio_luce_new
tappo_11.5
