cosidelu/vision-guided-helmet-inspection/cad/Front_support/Supporto davanti.SLDASM

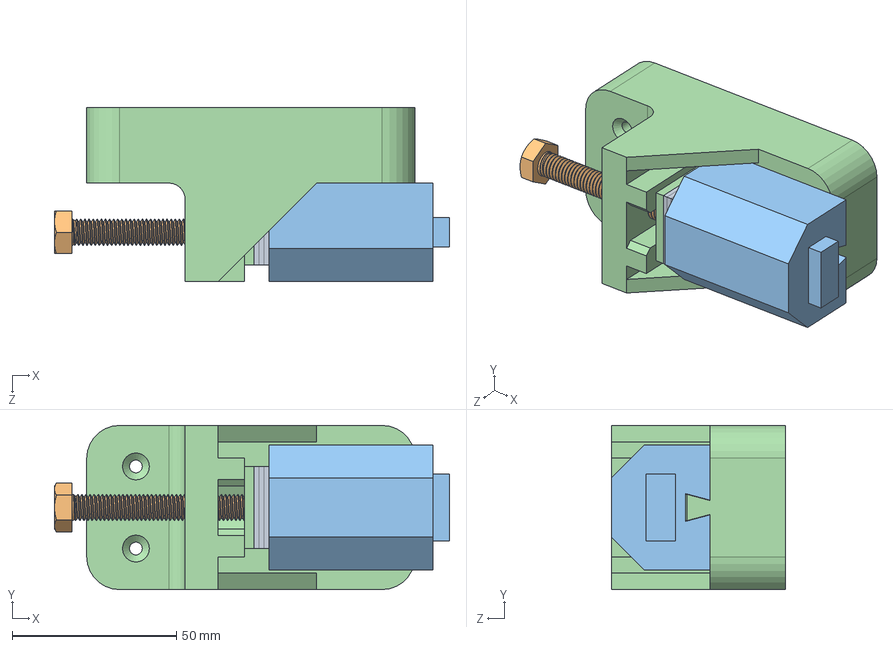
[picture p61: CAD file, 2026-09-28]
cad/Front_support/Supporto davanti.SLDASM
120.3 x 50.0 x 53.0 mm
spinta_davantiV3
push_casco_foro_lungo
91280A596_Medium-Strength Class 8.8 Steel Hex Head Screw
distanziale x 3
