cosidelu/vision-guided-helmet-inspection/cad/Back_support/Back.SLDASM

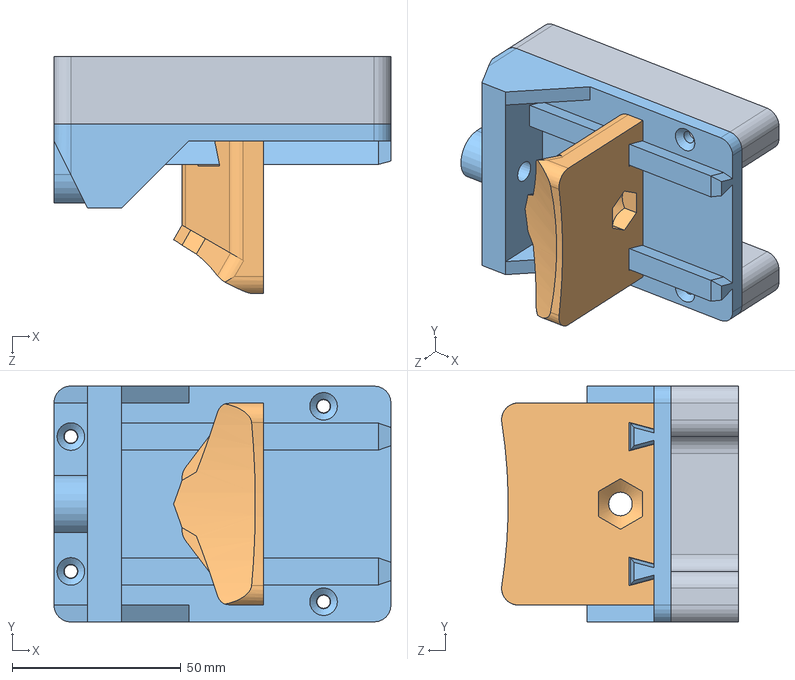
[picture p62: CAD file, 2026-09-28]
cad/Back_support/Back.SLDASM
100.0 x 70.0 x 70.3 mm
Back_base_0804
Back_support_0704
Rialzo
