cosidelu/vision-guided-helmet-inspection/cad/End-Effector/ASSEMBLY.STL

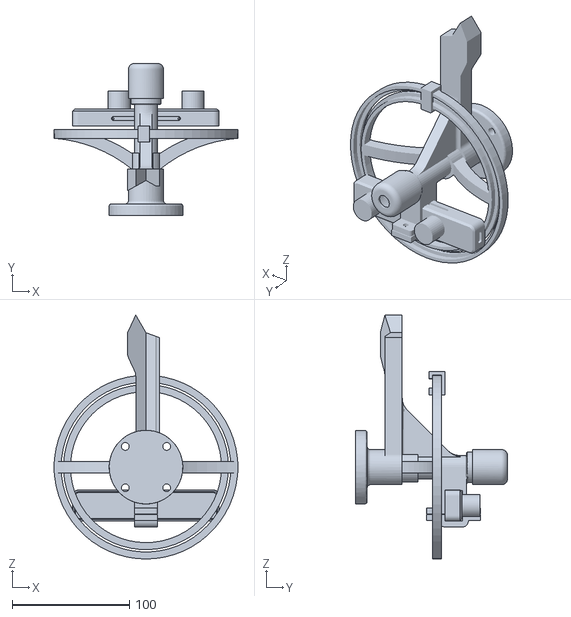
[picture p63: CAD file, 2026-09-28]
cad/End-Effector/ASSEMBLY.STL
157.0 x 130.0 x 208.5
