cosidelu/vision-guided-helmet-inspection/cad/Back_support/Back_base_0804.SLDPRT

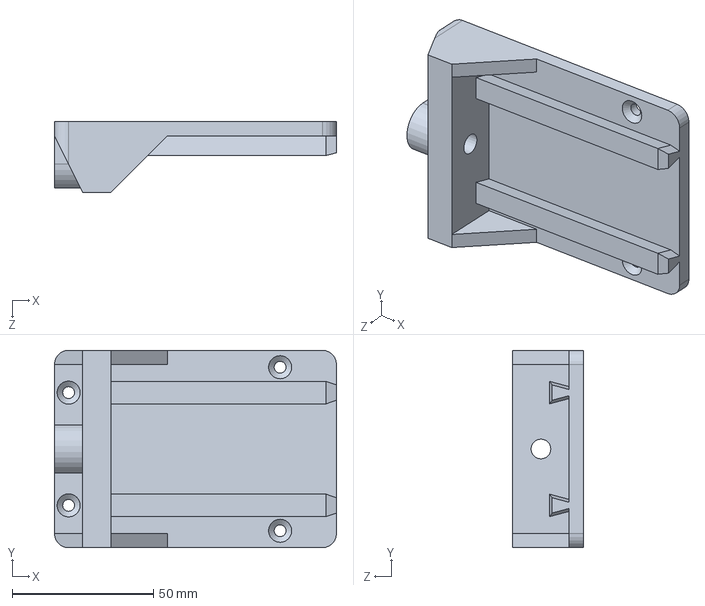
[picture p64: CAD file, 2026-09-28]
cad/Back_support/Back_base_0804.SLDPRT
100.0 x 70.0 x 25.0 mm
