cosidelu/vision-guided-helmet-inspection/cad/Front_support/push_casco_foro_lungo.SLDPRT

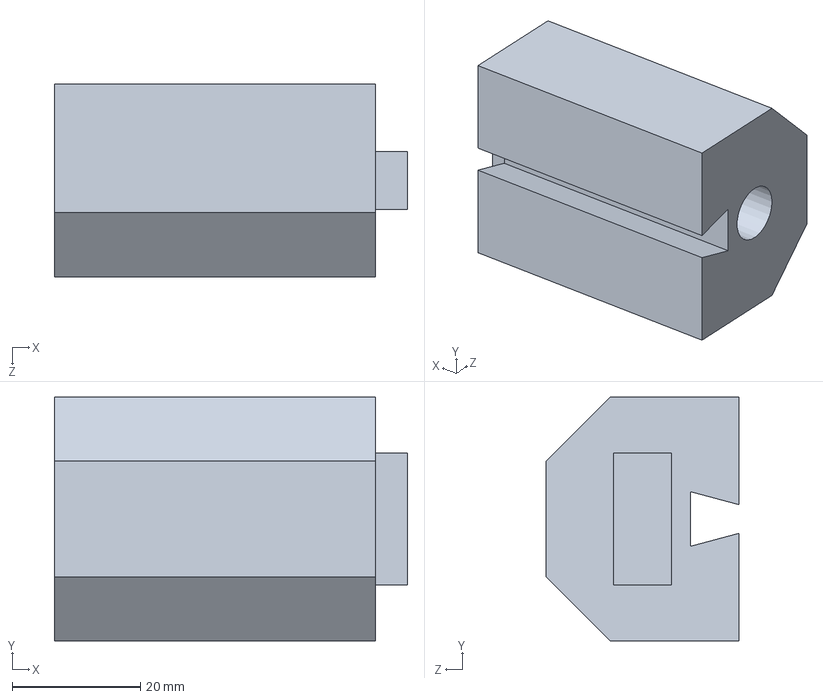
[picture p65: CAD file, 2026-09-28]
cad/Front_support/push_casco_foro_lungo.SLDPRT
55.0 x 38.0 x 30.0 mm
