cosidelu/vision-guided-helmet-inspection/cad/Back_support/Rialzo.SLDPRT

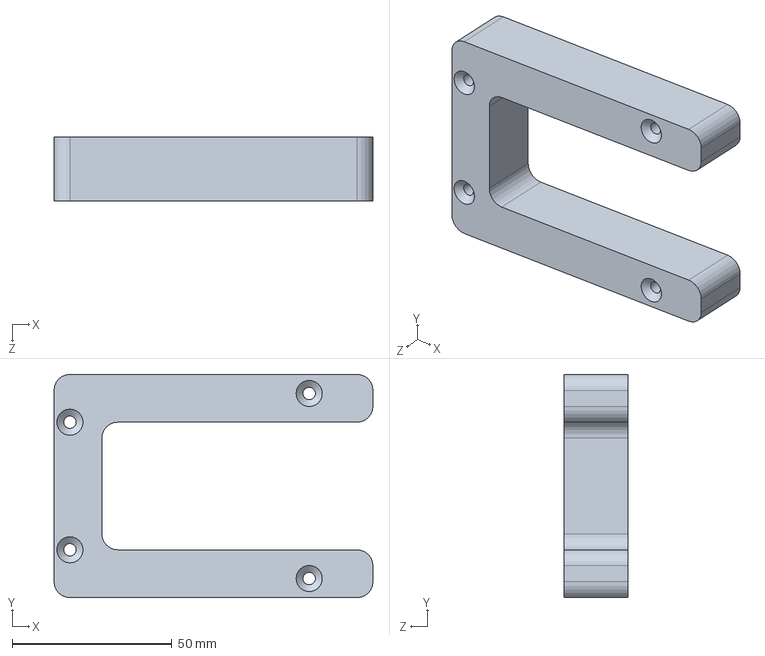
[picture p66: CAD file, 2026-09-28]
cad/Back_support/Rialzo.SLDPRT
100.0 x 70.0 x 20.0 mm
