cosidelu/vision-guided-helmet-inspection/cad/End-Effector/supporto_luce_tasche_3.SLDPRT

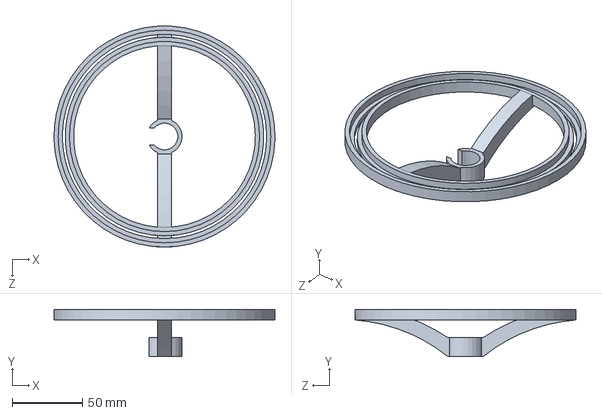
[picture p67: CAD file, 2026-09-28]
cad/End-Effector/supporto_luce_tasche_3.SLDPRT
156.9 x 33.5 x 157.0 mm
