cosidelu/vision-guided-helmet-inspection/cad/Back_support/Back_support_0704.SLDPRT

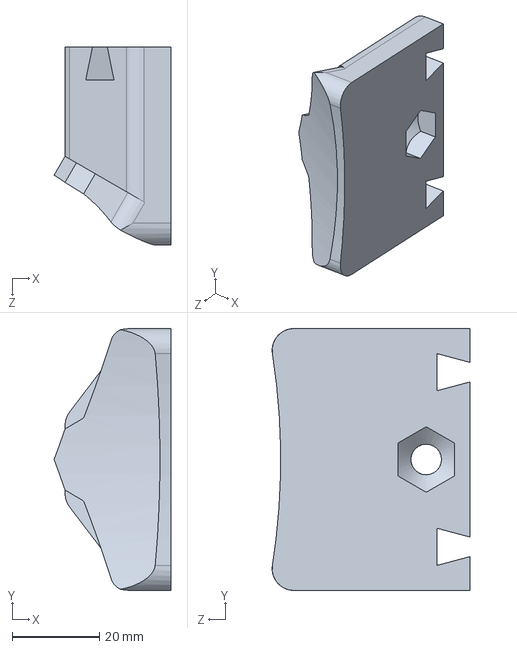
[picture p68: CAD file, 2026-09-28]
cad/Back_support/Back_support_0704.SLDPRT
26.7 x 60.0 x 45.3 mm
