cosidelu/vision-guided-helmet-inspection/cad/End-Effector/coperchio con scanalatura.SLDPRT

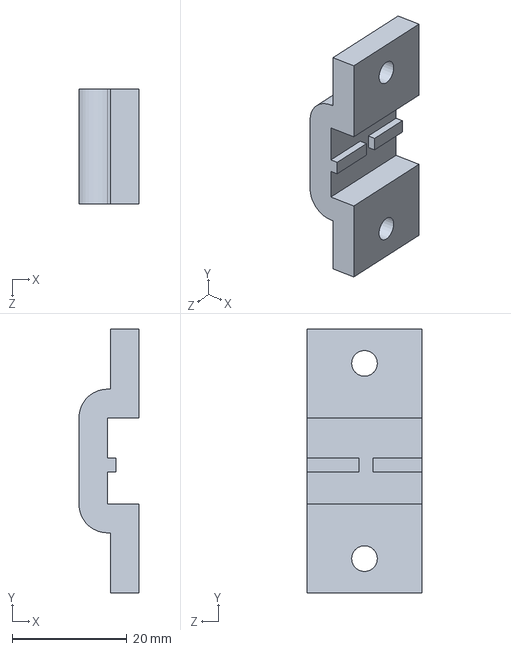
[picture p69: CAD file, 2026-09-28]
cad/End-Effector/coperchio con scanalatura.SLDPRT
10.5 x 46.1 x 20.0 mm
