cosidelu/vision-guided-helmet-inspection/cad/Front_support/distanziale.SLDPRT

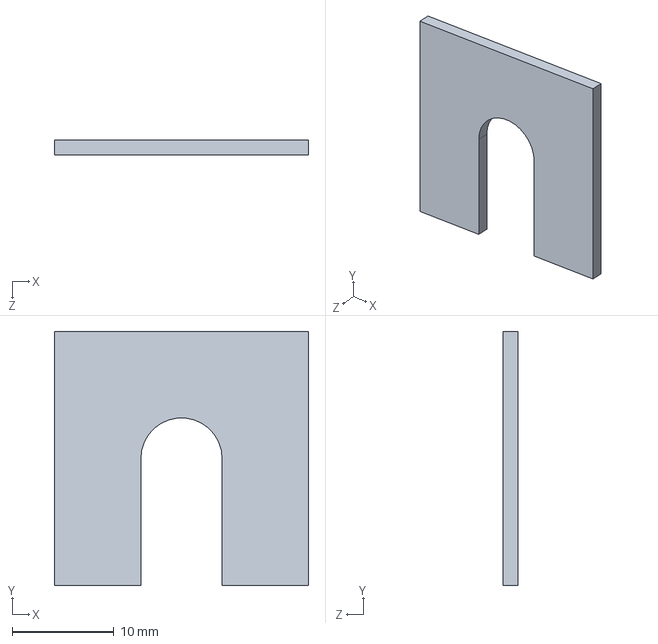
[picture p70: CAD file, 2026-09-28]
cad/Front_support/distanziale.SLDPRT
25.0 x 25.0 x 1.50 mm
