cosidelu/vision-guided-helmet-inspection/cad/Front_support/spinta_davantiV3.SLDPRT

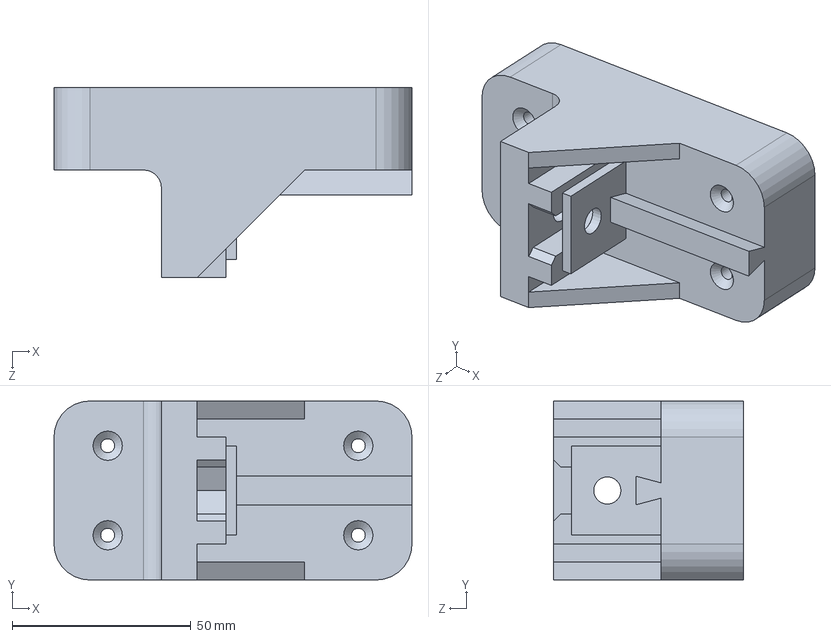
[picture p71: CAD file, 2026-09-28]
cad/Front_support/spinta_davantiV3.SLDPRT
100.0 x 50.0 x 53.0 mm
