cosidelu/vision-guided-helmet-inspection/cad/End-Effector/end_effector_3.SLDPRT

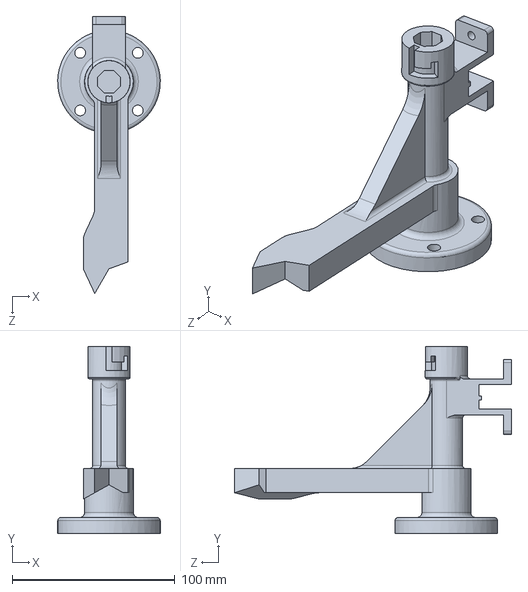
[picture p72: CAD file, 2026-09-28]
cad/End-Effector/end_effector_3.SLDPRT
63.0 x 115.0 x 170.0 mm
