cosidelu/vision-guided-helmet-inspection/cad/End-Effector/tappo_11.5.SLDPRT

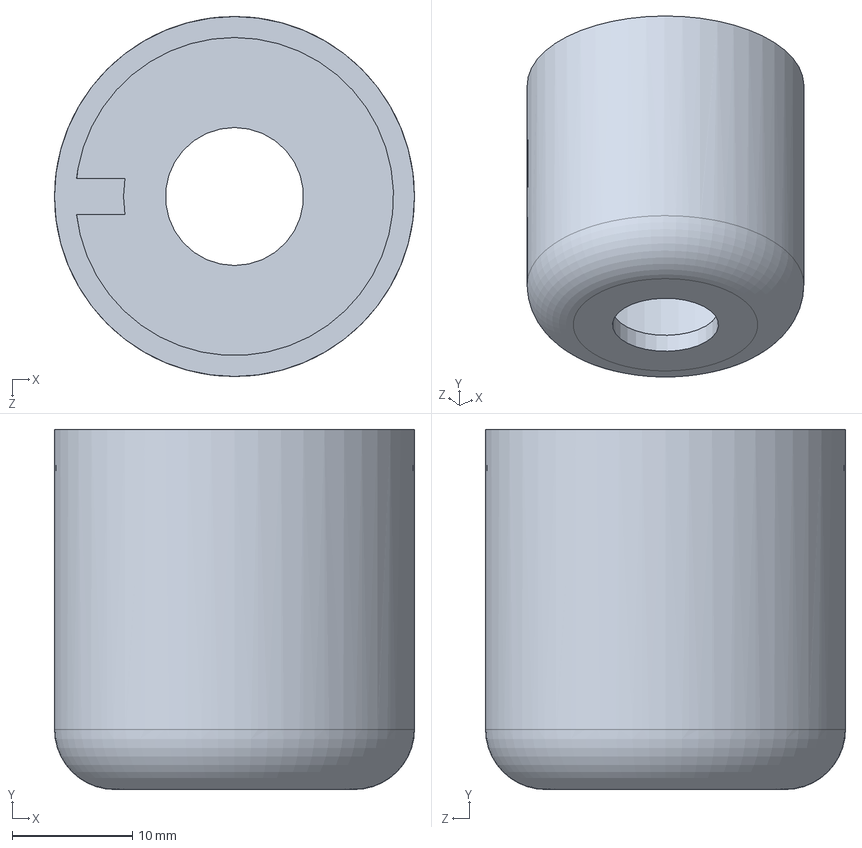
[picture p73: CAD file, 2026-09-28]
cad/End-Effector/tappo_11.5.SLDPRT
30.0 x 30.0 x 30.0 mm
