cosidelu/vision-guided-helmet-inspection/cad/End-Effector/gancio_luce_new.SLDPRT

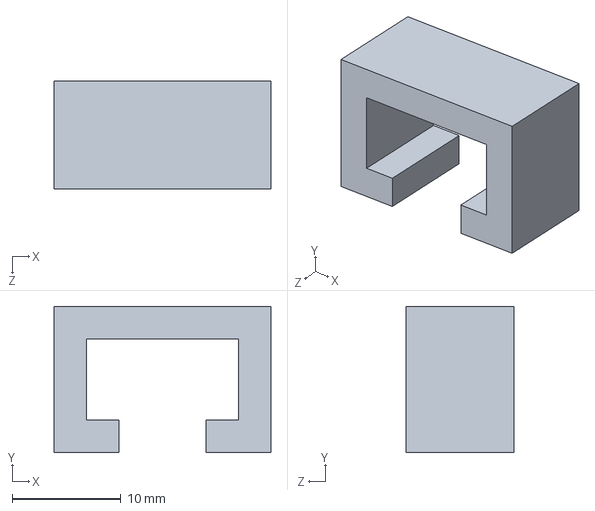
[picture p74: CAD file, 2026-09-28]
cad/End-Effector/gancio_luce_new.SLDPRT
20.0 x 13.5 x 10.0 mm
