cosidelu/vision-guided-helmet-inspection/cad/Front_support/91280A596_Medium-Strength Class 8.8 Steel Hex Head Screw.SLDPRT

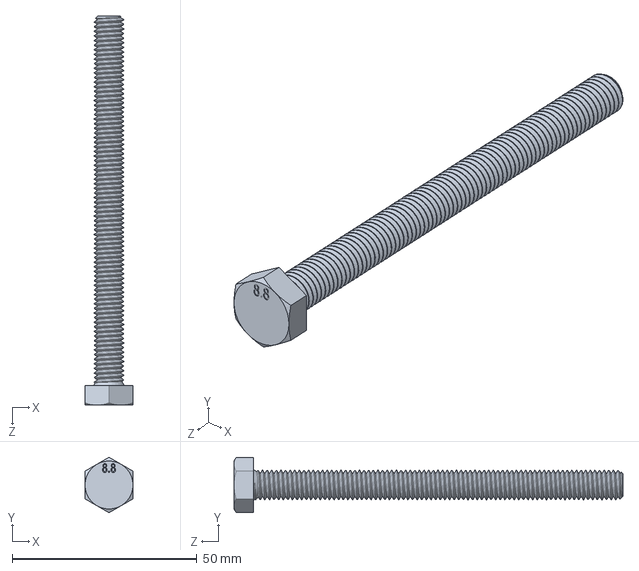
[picture p75: CAD file, 2026-09-28]
cad/Front_support/91280A596_Medium-Strength Class 8.8 Steel Hex Head Screw.SLDPRT
13.0 x 15.0 x 105.3 mm
