cosidelu/vision-guided-helmet-inspection/(list of files, cad)

Other CAD files:
cad/End-Effector/ZEDM.SLDASM
